LuizBraz13/TCU-Projects/Anexo1_TER/IEL 4 Anexo 1,2 e sede-Instalação elétrica-Iluminação-Térreo-IEL 4.pdf

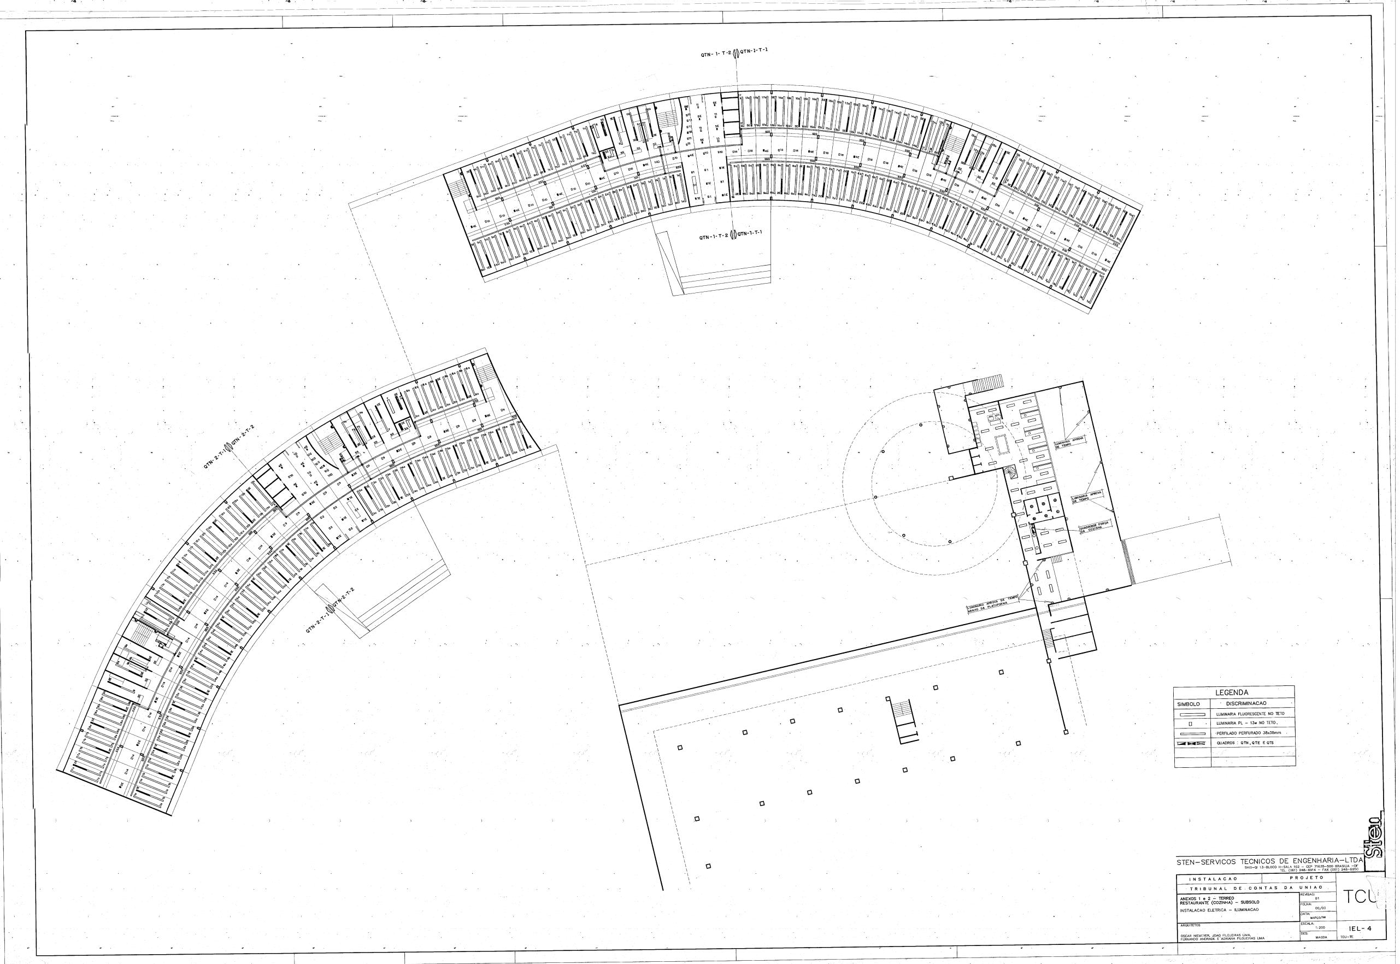
[picture p1: page 1]
