LuizBraz13/TCU-Projects/(list of files, cad)

Other CAD files:
Anexo1_PAV2/AN 1_2 PAVc.dwg
Anexo1_PAV4/AN 1_4 PAV_2017c.dwg
Anexo1_SUB/AN 1_SUBc.dwg
Anexo1_TER/02-01_ANEXO-I_TER_ILUMINAÇÃO_R00.dwg
Anexo_I_II_PERGOLADO.DWG/INTERCONEXÃO DOS MÓDULOS_ANEXO I, II e PERGOLADO.dwg
Check list PE Anexo I,II e Pergolado/2018-06-05 PROJETOS_V02/DWG/ALOCAÇÃO DOS MÓDULOS/ALOCAÇÃO DE MÓDULOS - ANEXO I, II e PERGOLADO.dwg
Check list PE Anexo I,II e Pergolado/2018-06-12 PROJETOS_V01/ALOCAÇÃO DE MÓDULOS/ALOCAÇÃO DE MÓDULOS_ANEXO I, II e PERGOLADO_v10.dwg
Check list PE Anexo I,II e Pergolado/2018-06-12 PROJETOS_V01/INFRAESTRUTURA/INFRAESTRUTURA_TCU_ANEXO I, II e Pergolado_v09.dwg
Check list PE Anexo I,II e Pergolado/2018-06-12 PROJETOS_V01/INTERCONEXÃO DOS MÓDULOS/INTERCONEXÃO DOS MÓDULOS_ANEXO I, II e PERGOLADO.dwg
Check list PE Anexo I,II e Pergolado/2018-06-12 PROJETOS_V01/LEVANTAMENTO NA MANTA - ANEXOS I e II/LEVANTAMENTO DA MANTA - ANEXOS I e II_v02.dwg
Anexo1_PAV2/05-01_ANEXO-I_2PAV_ILUMINAÇÃO_R00.dwg
Anexo1_SUB/01-01_ANEXO-I_SUB_ILUMINAÇÃO_R00c.dwg
Anexo1_TER/01-01_ANEXO-I_TER_ILUMINAÇÃO_R00c.dwg
Anexo_I_II_PERGOLADO.DWG/LEVANTAMENTO DA MANTA - ANEXOS I e II.dwg
Anexo1_TER/AN 1_TER_2018c.dwg
