LuizBraz13/TCU-Projects/Anexo1_SUB/AN 1_SUBc.pdf

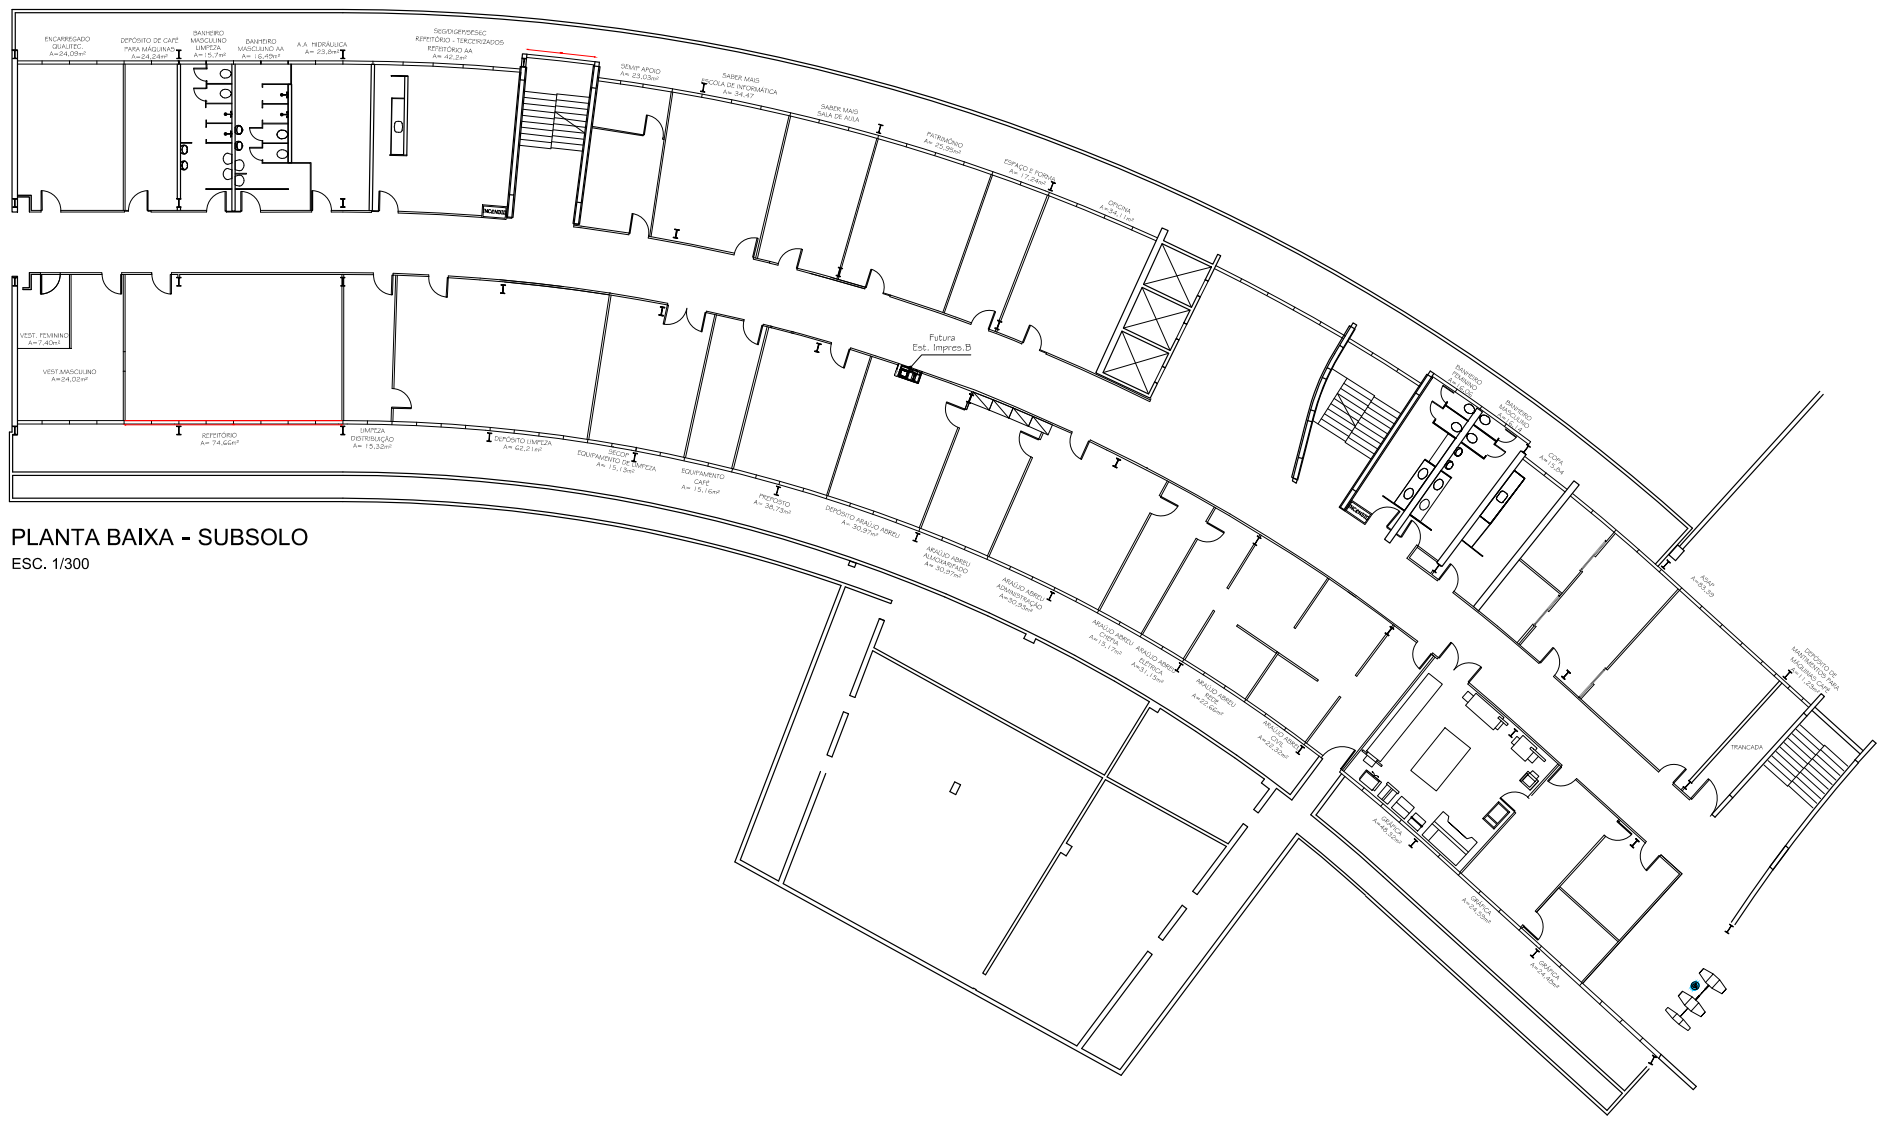
[picture p19: page 1]
