LuizBraz13/TCU-Projects/Anexo1_PAV2/01-01_ANEXO-I_2PAV_ILUMINAÇÃO_R00c.pdf

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

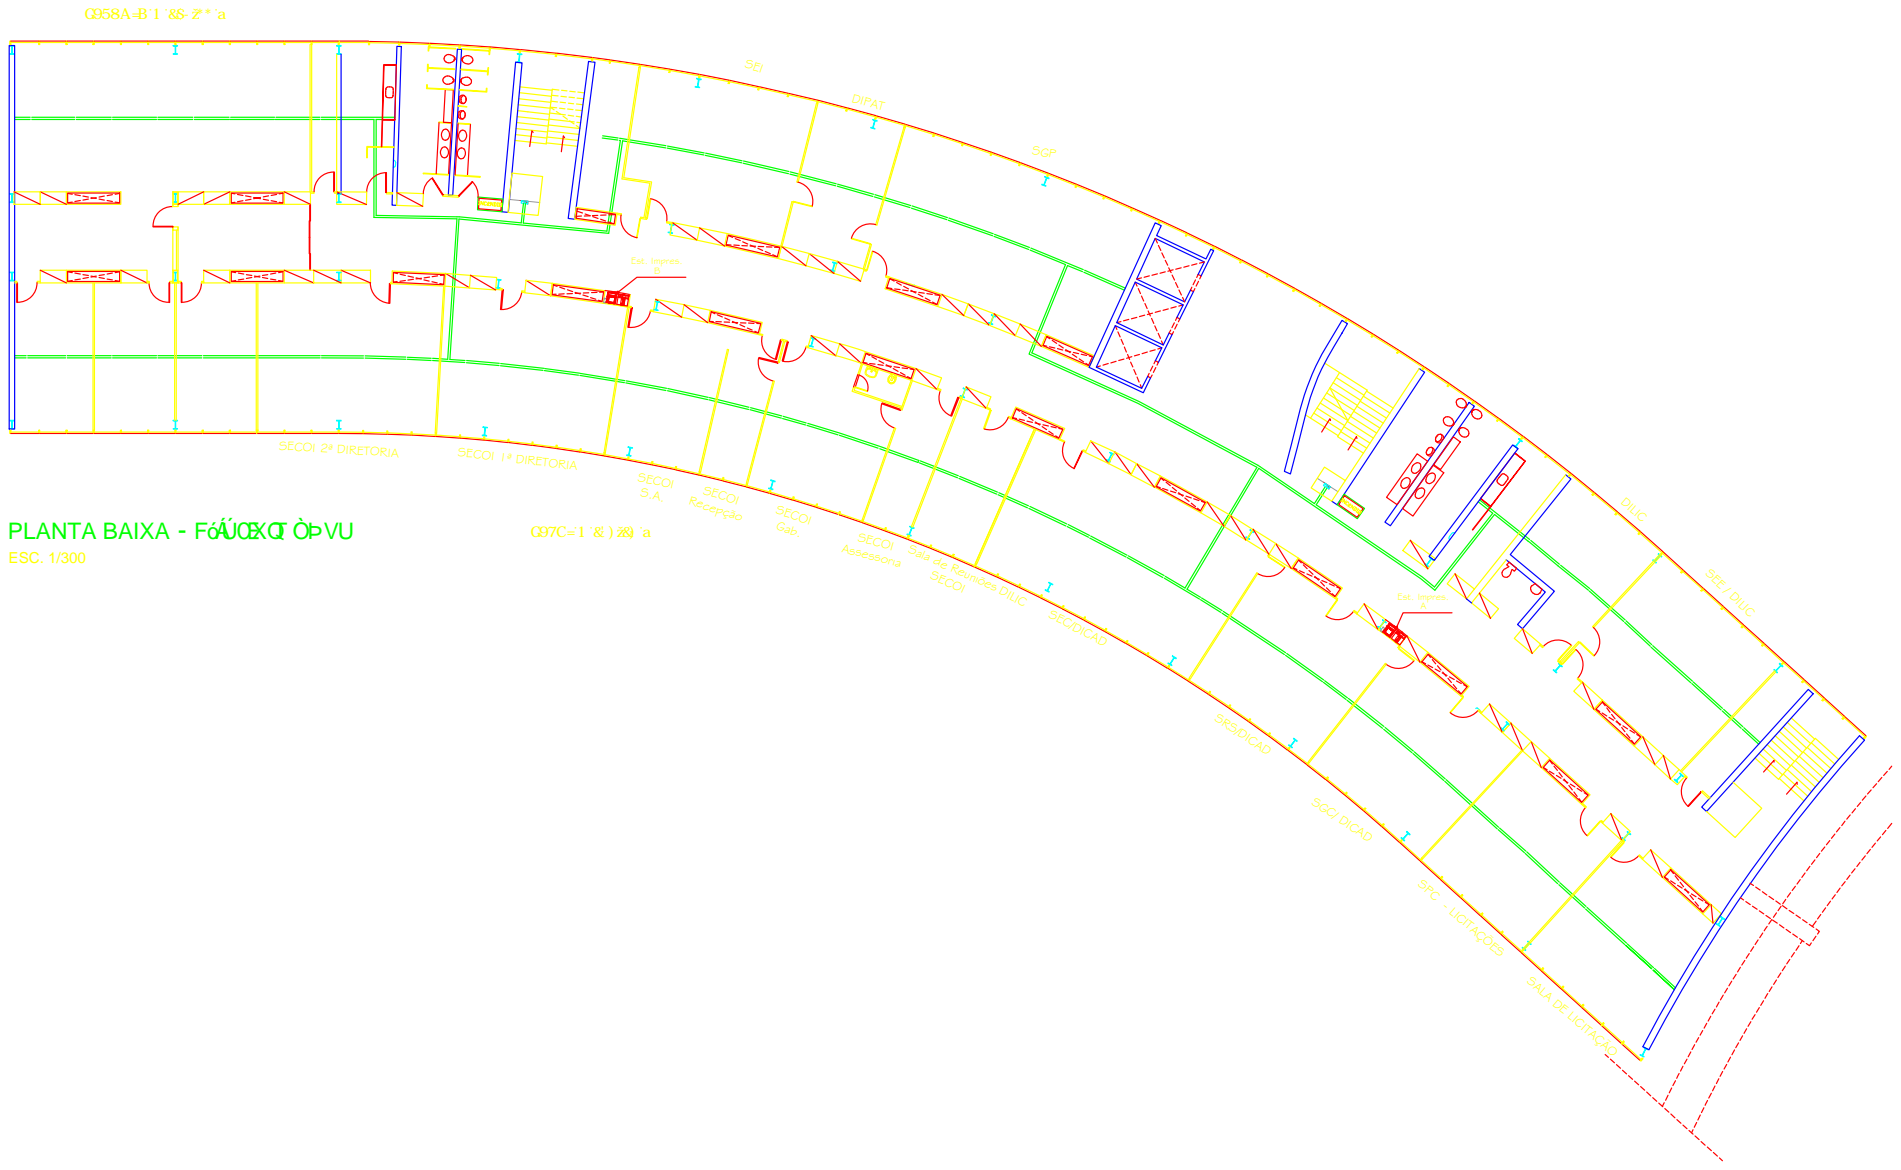
[picture p20: page 1]
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
