LuizBraz13/TCU-Projects/Anexo1_PAV4/01-01_ANEXO-I_4PAV_ILUMINAÇÃO_R00c.pdf

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

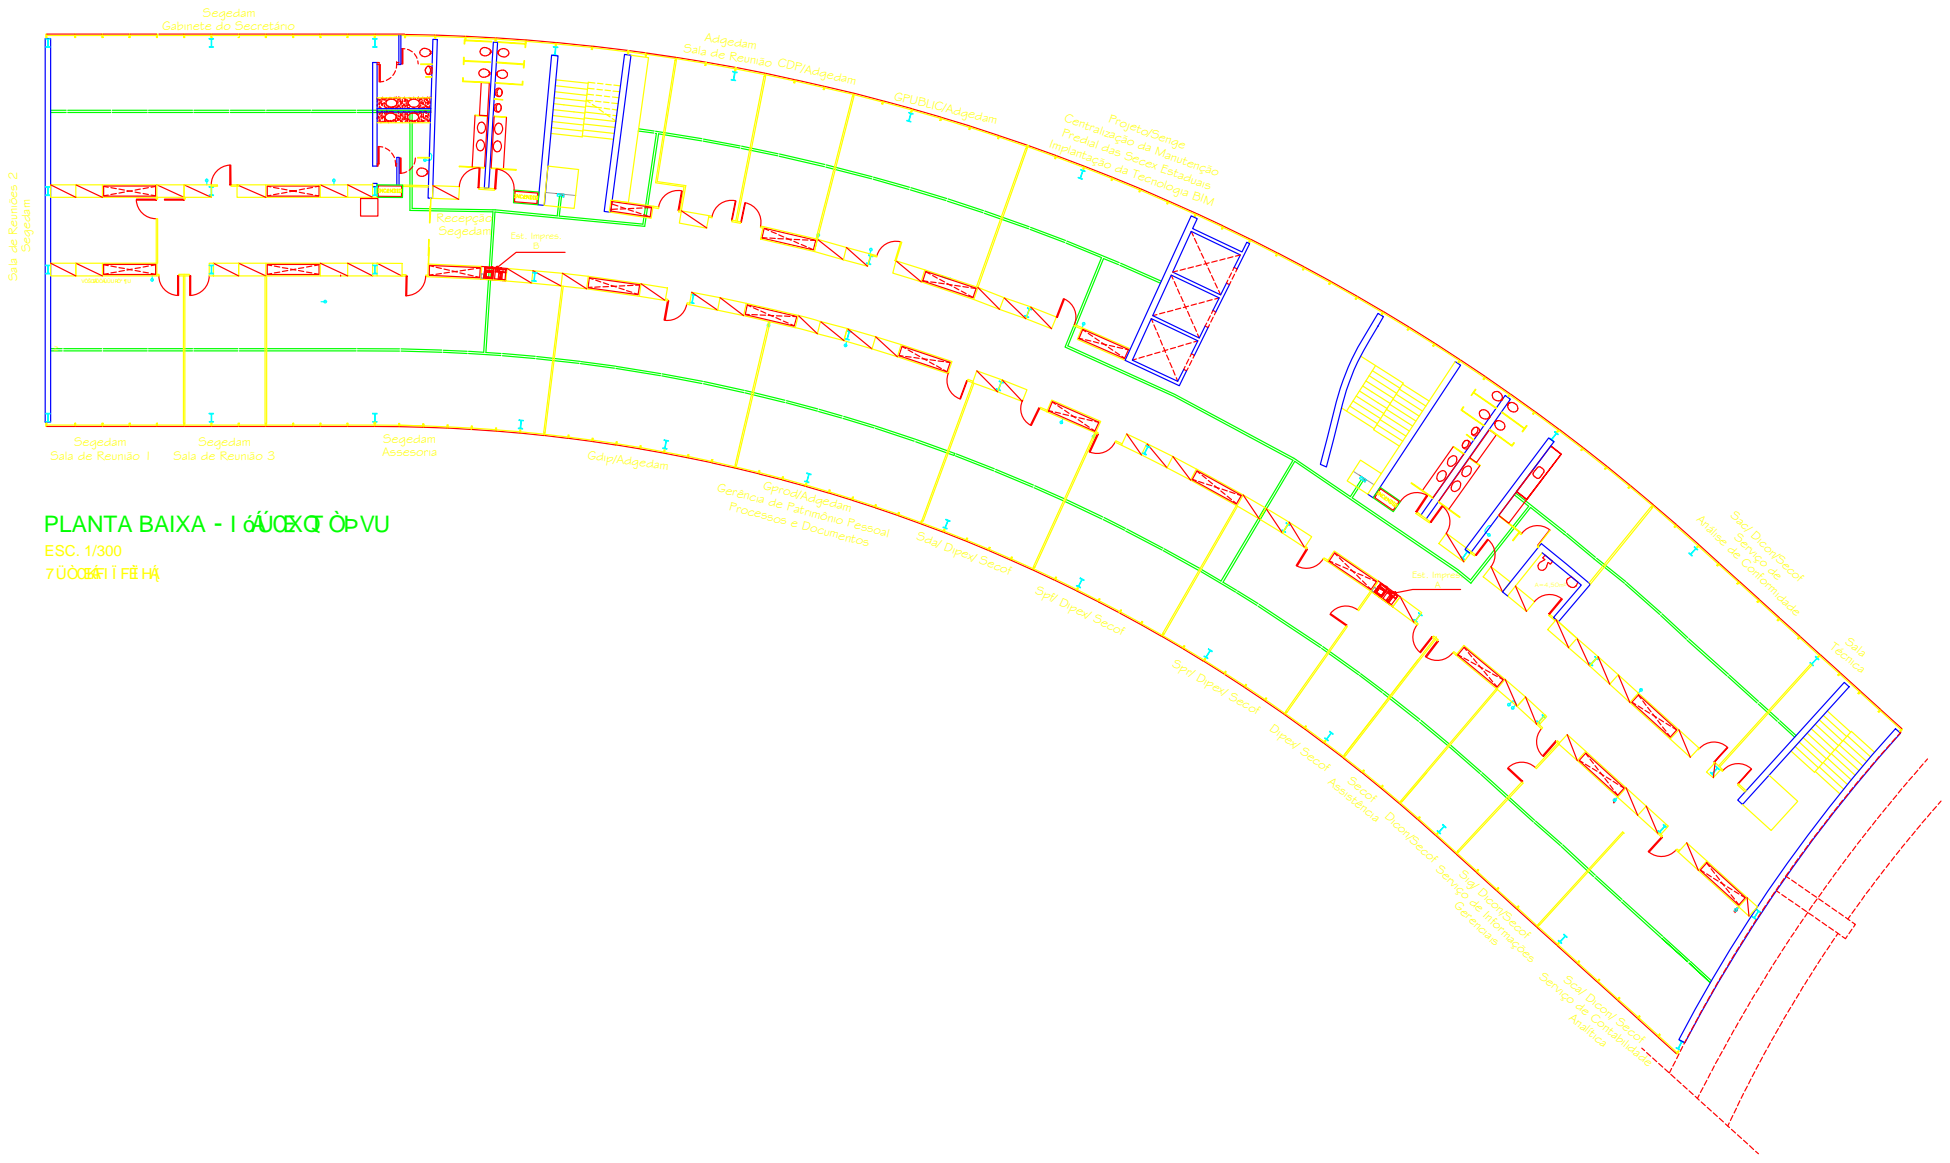
[picture p21: page 1]
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
