LuizBraz13/TCU-Projects/Check list PE Anexo I,II e Pergolado/2018-06-05_Simulação Anexos I II e Pergolado/02-Interconexão/INTERCONEXÃO ANEXO I - 02.pdf

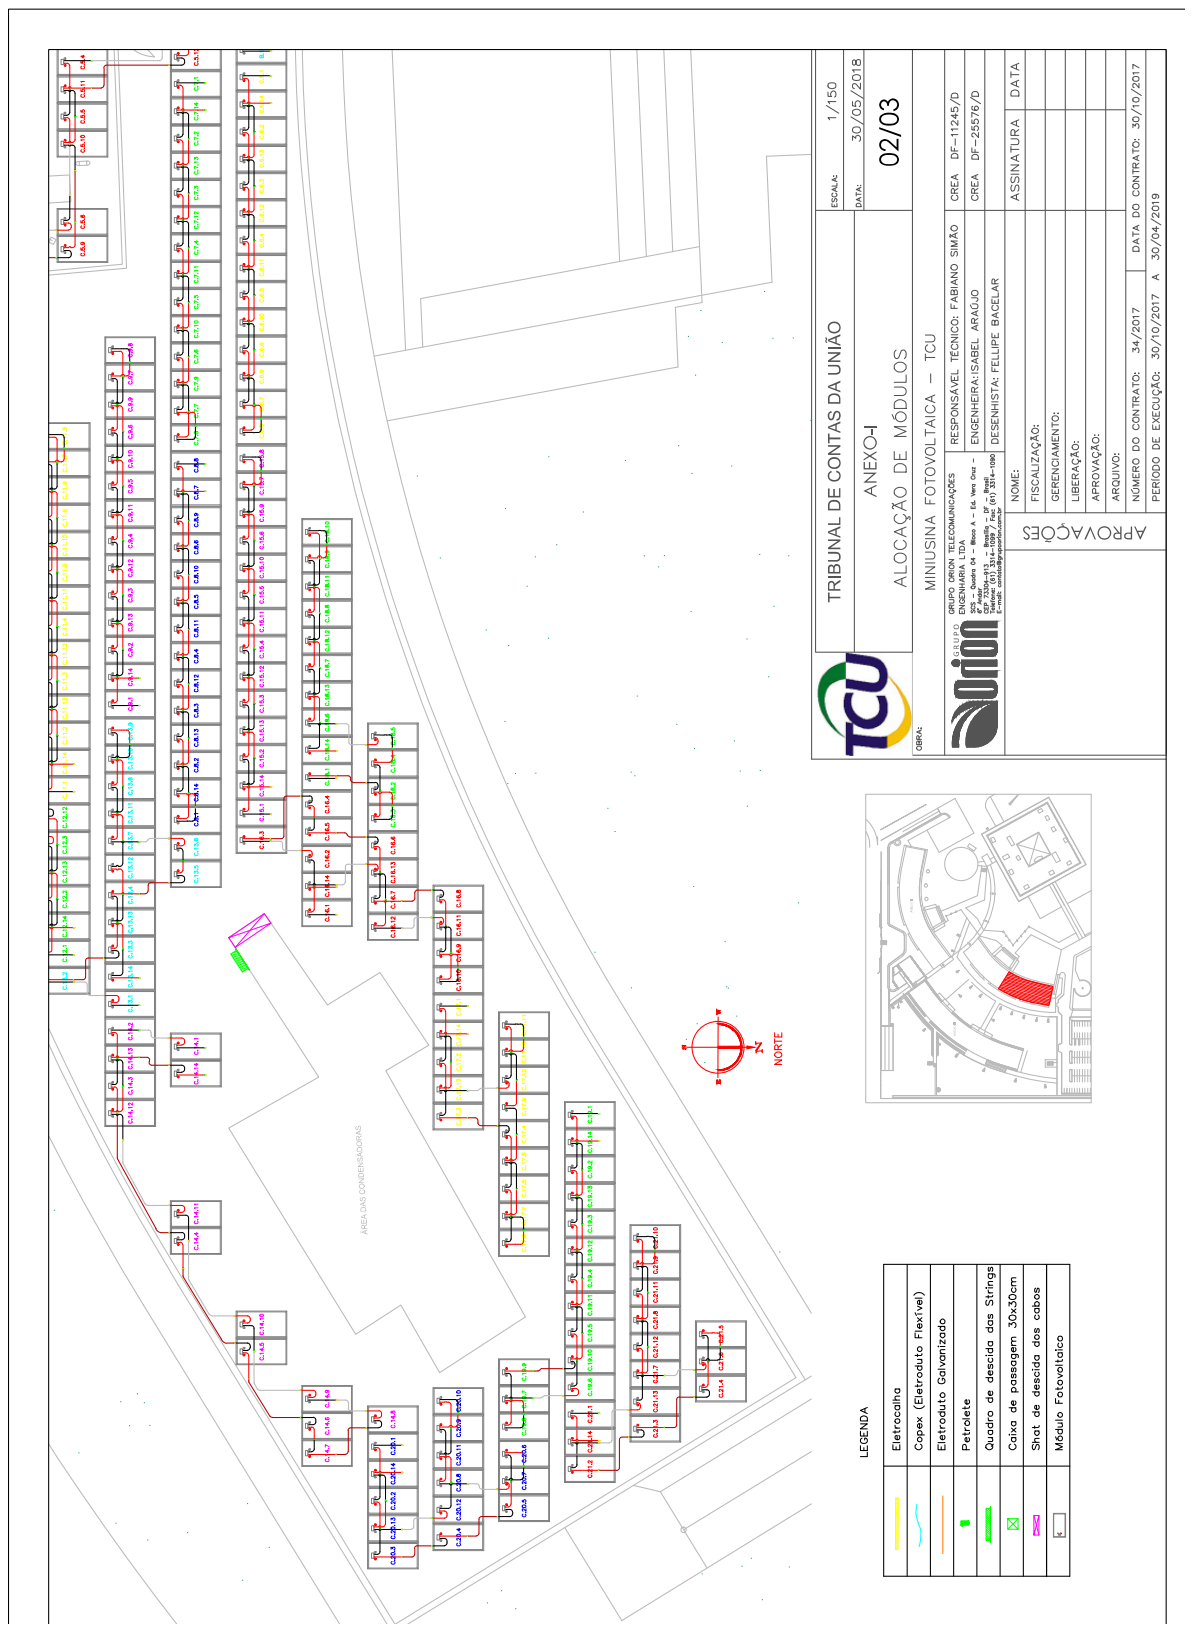
[picture p23: page 1]
