LuizBraz13/TCU-Projects/Check list PE Anexo I,II e Pergolado/2018-06-05_Simulação Anexos I II e Pergolado/02-Interconexão/INTERCONEXÃO ANEXO II - 02.pdf

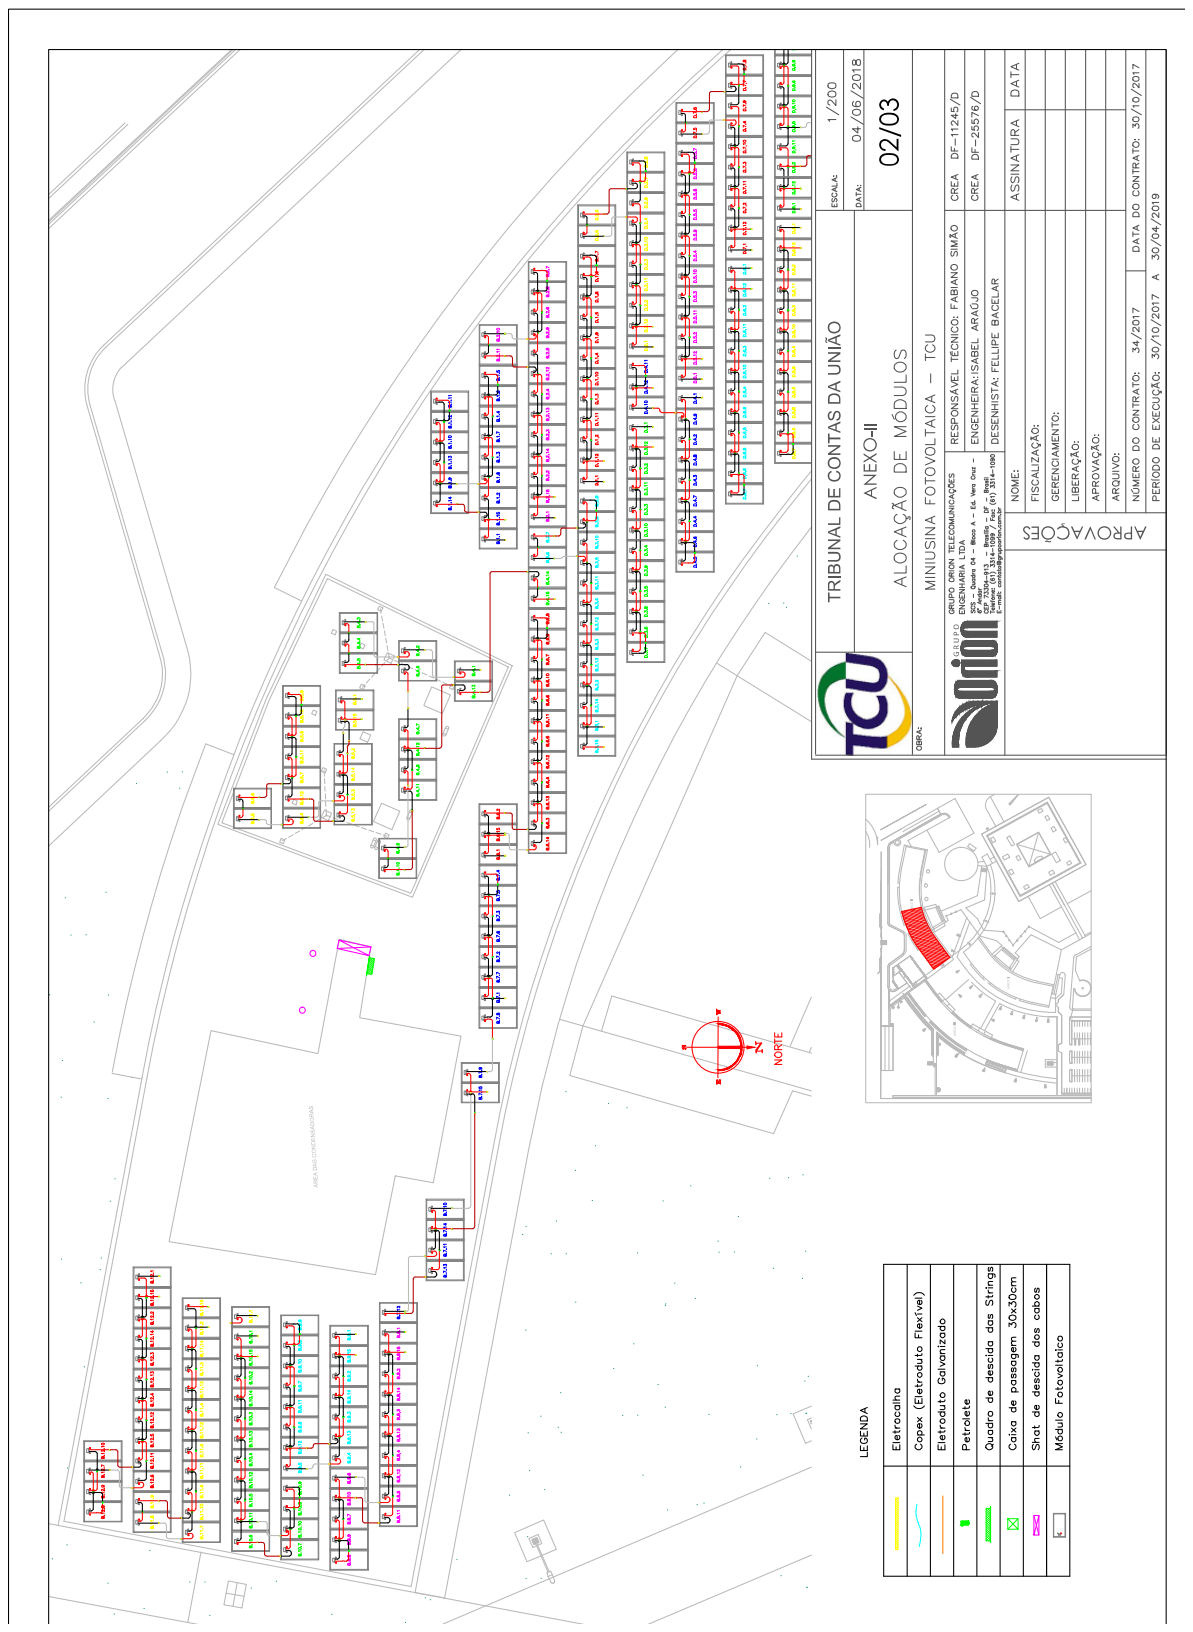
[picture p26: page 1]
