LuizBraz13/TCU-Projects/Check list PE Anexo I,II e Pergolado/2018-06-12 PROJETOS_V01/ALOCAÇÃO DE MÓDULOS/ALOCAÇÃO DE MÓDULOS ANEXO II 03.pdf

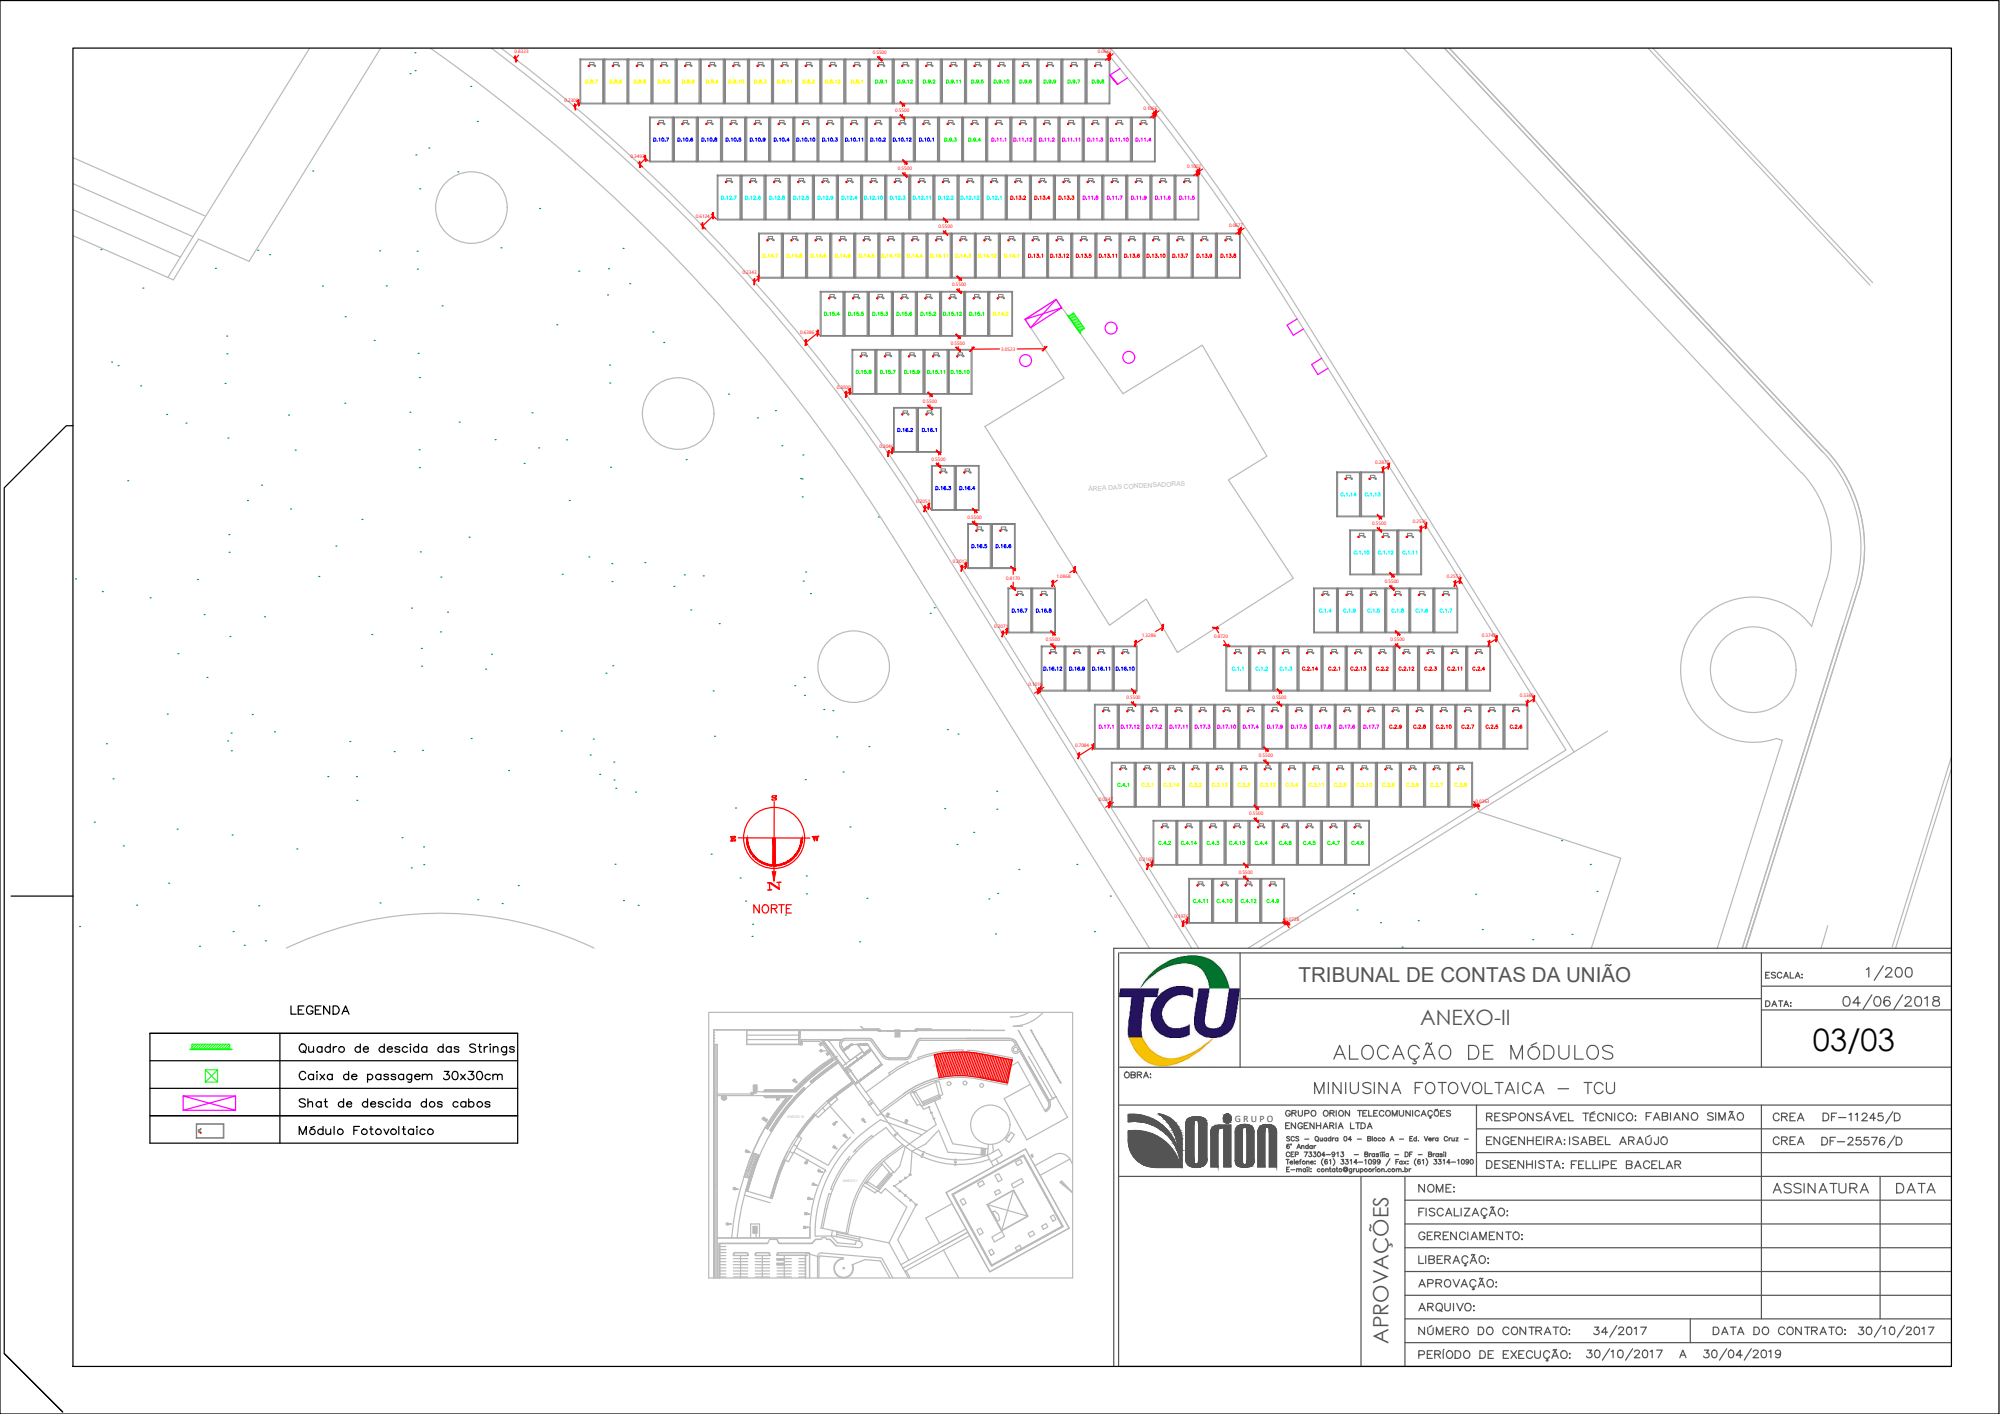
[picture p33: page 1]
ANEXO I; ANEXO II; ANEXO III

ÁREA DAS CONDENSADORAS

TRIBUNAL DE CONTAS DA UNIÃO
