LuizBraz13/TCU-Projects/Check list PE Anexo I,II e Pergolado/2018-06-12 PROJETOS_V01/INFRAESTRUTURA/INFRA ANEXO I 01.pdf

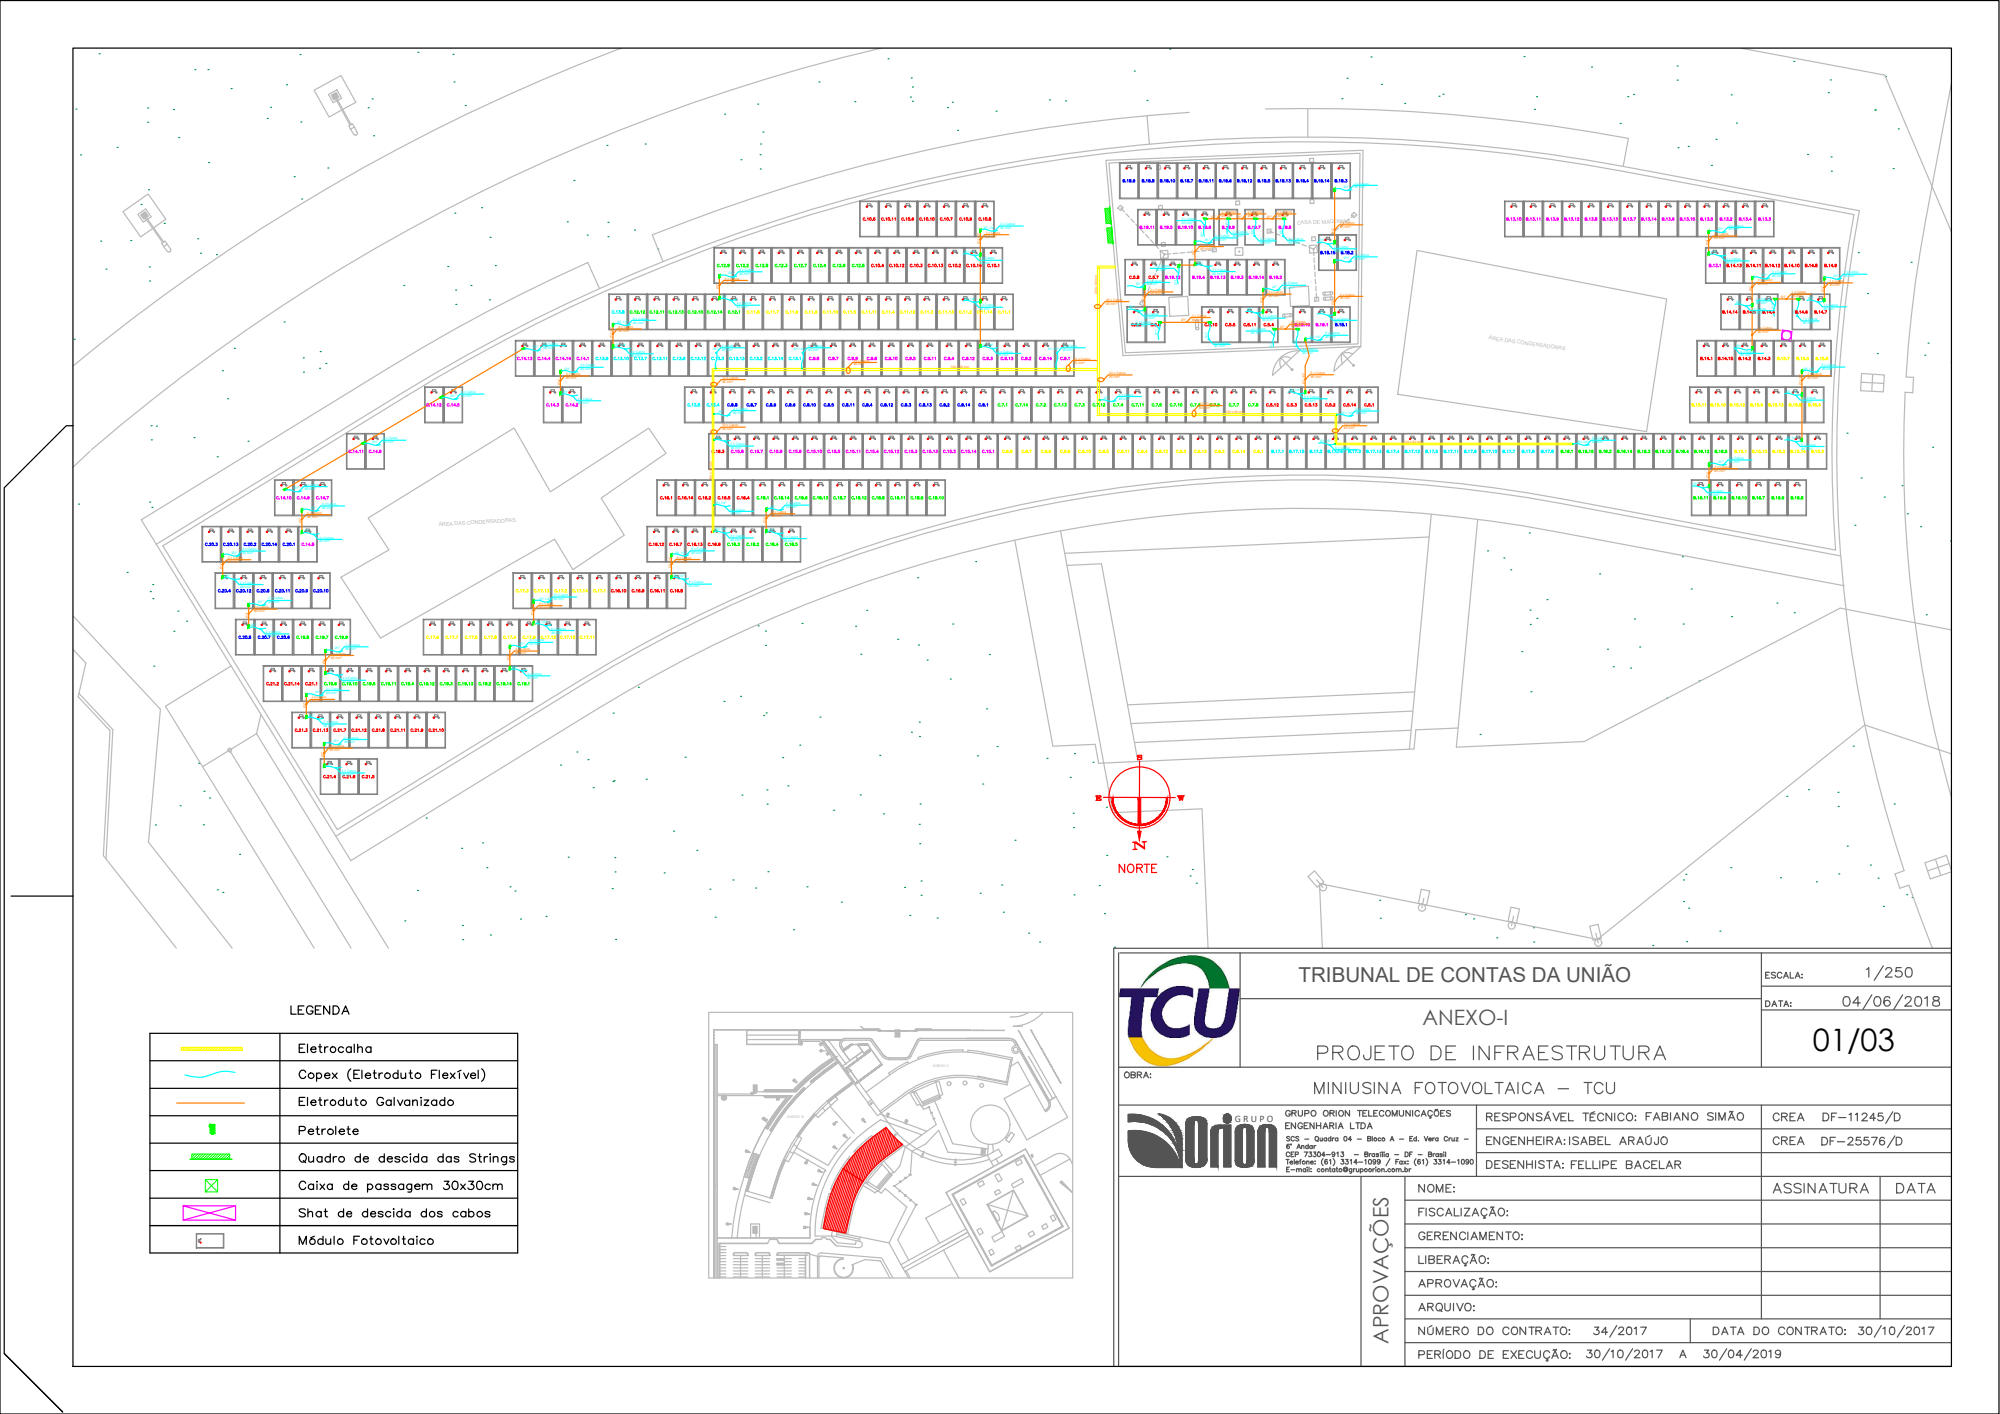
[picture p35: page 1]
2 x Cabos #6 mm² Ø1"; 2 x Cabos #6 mm²; 1 x Cabos #6 mm² Ø1"; 1 x Cabos #6 mm²; 3 x Cabos #6 mm² Ø1"; 3 x Cabos #6 mm²; Ø1"4 x Cabos #6 mm²; 2 x Cabos #6 mm² Ø1.1/4"; 6 x Cabos #6 mm²; 2 x Cabos #6 mm² Ø1" Ø1"; 6 x Cabos #6 mm² Ø1.1/4"; 2 x Cabos Ø1"; #6 mm² Ø1"; 4 x Cabos Ø1"; 4 x Cabos #6 mm²; 4 x Cabos #6 mm² Ø1"; #6 mm² 2 x Cabos Ø1"; 1 x Cabos Ø1"; 8 x Cabos #6 mm² Ø1.1/4"; 8 x Cabos #6 mm²; 10 x Cabos #6 mm²; 12 x Cabos #6 mm² 100 x 50 mm; Ø1.1/4" 8 x Cabos Ø1.1/4"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

CASA DE MÁQUINAS

ÁREA DAS CONDENSADORAS

TRIBUNAL DE CONTAS DA UNIÃO
