LuizBraz13/TCU-Projects/Check list PE Anexo I,II e Pergolado/2018-06-12 PROJETOS_V01/INFRAESTRUTURA/INFRA ANEXO I 02.pdf

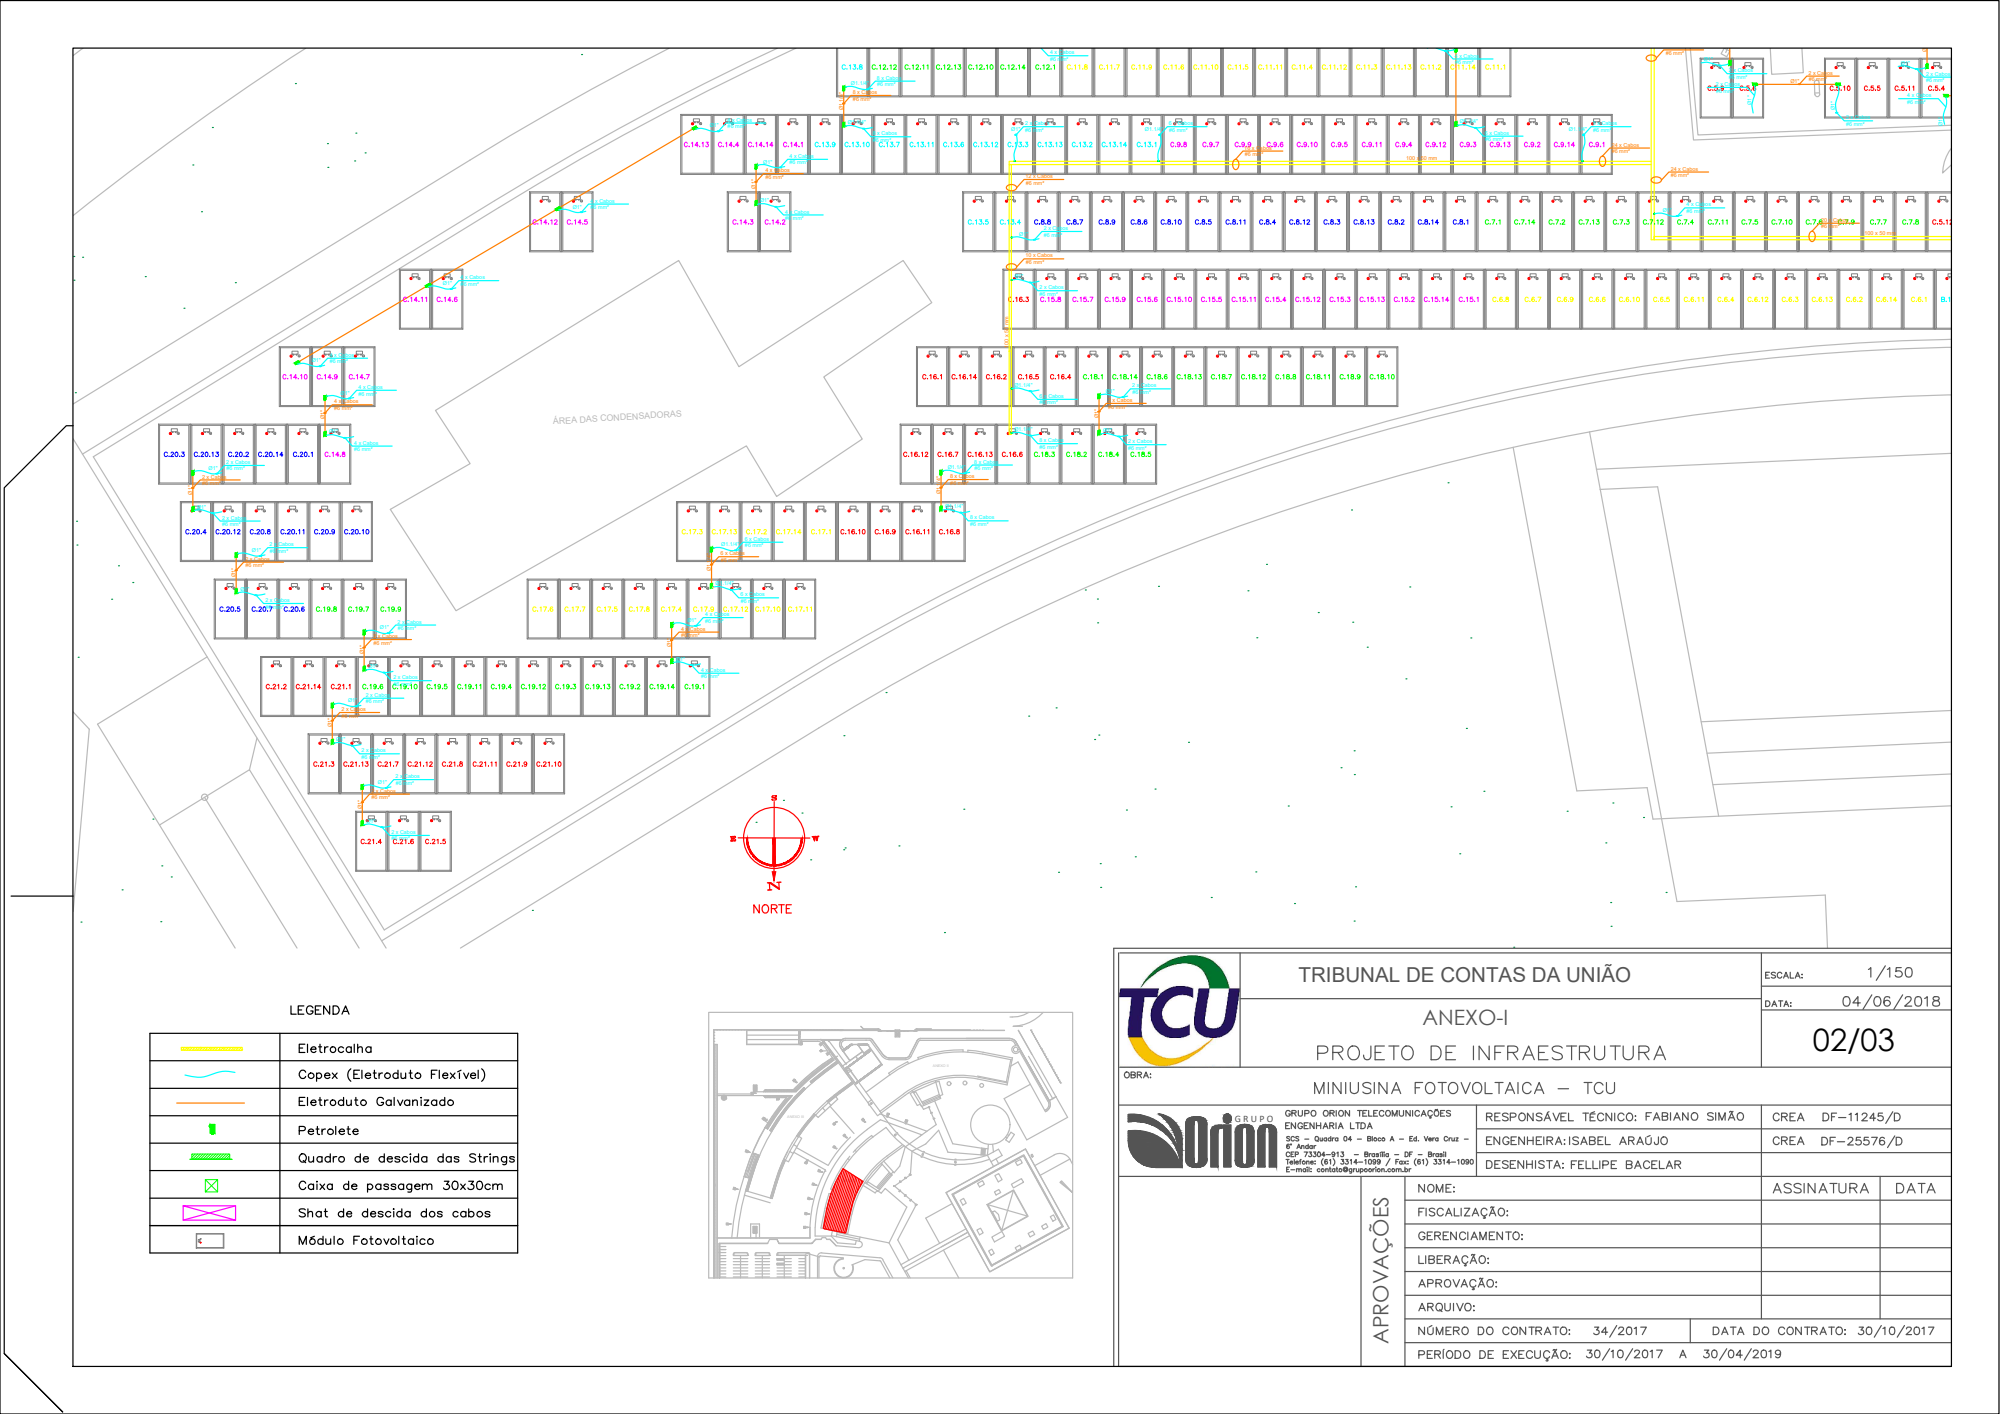
[picture p36: page 1]
2 x Cabos #6 mm²; 2 x Cabos #6 mm² 2 x Cabos Ø1"; #6 mm² Ø1"; 4 x Cabos #6 mm²; 2 x Cabos #6 mm² Ø1"; 4 x Cabos #6 mm² Ø1"; 6 x Cabos #6 mm² Ø1.1/4"; 6 x Cabos #6 mm²; 8 x Cabos #6 mm² Ø1.1/4"; 8 x Cabos #6 mm²; 10 x Cabos #6 mm²; Ø1.1/4" 8 x Cabos Ø1.1/4"; #6 mm² 6 x Cabos Ø1"; #6 mm² 2 x Cabos #6 mm²; 48 x Cabos #6 mm²; 24 x Cabos #6 mm²; 16 x Cabos #6 mm²; 20 x Cabos #6 mm²; ANEXO I; ANEXO II; ANEXO III

ÁREA DAS CONDENSADORAS Ø1"

12 x Cabos #6 mm² 100 x 50 mm

TRIBUNAL DE CONTAS DA UNIÃO
