LuizBraz13/TCU-Projects/Check list PE Anexo I,II e Pergolado/2018-06-12 PROJETOS_V01/INFRAESTRUTURA/INFRA ANEXO II 02.pdf

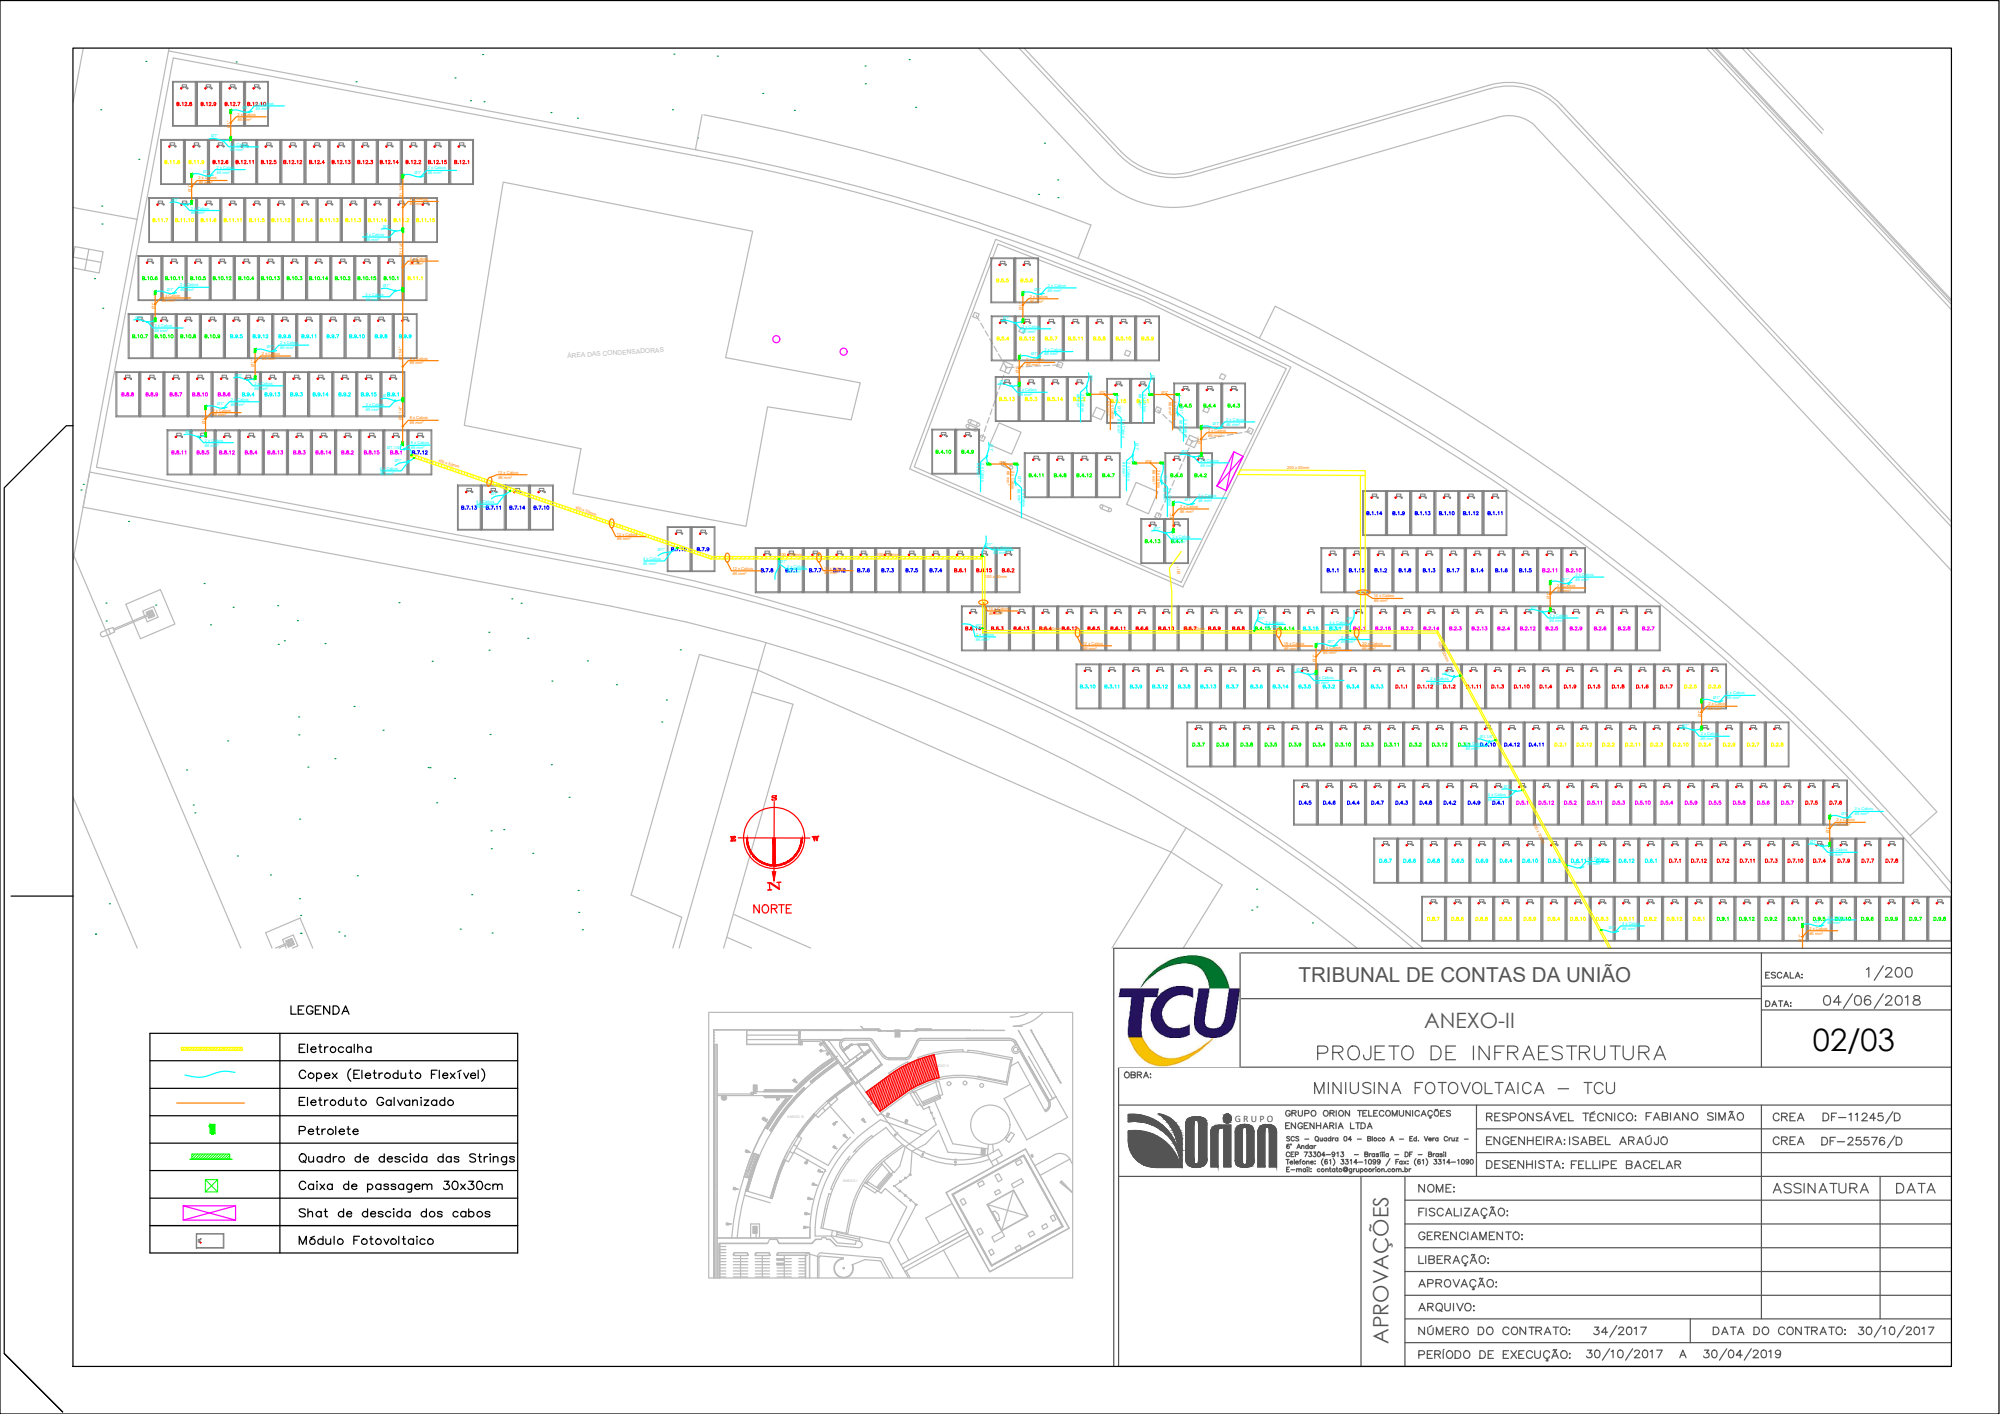
[picture p38: page 1]
2 x Cabos #6 mm² Ø1"; 2 x Cabos #6 mm²; 4 x Cabos #6 mm²; Ø1" 4 x Cabos #6 mm²; 8 x Cabos #6 mm²; 2 x Cabos #6 mm² Ø1.1/4"; Ø1" 2 x Cabos #6 mm²; Ø1" 3 x Cabos #6 mm²; 8 x Cabos #6 mm² Ø1.1/4" Ø1.1/4"; 6 x Cabos #6 mm² Ø1.1/4"; 12 x Cabos #6 mm²; 14 x Cabos #6 mm²; Ø1.1/4" 6 x Cabos #6 mm²; 16 x Cabos #6 mm²; 2 x Cabos #6 mm² #6 mm²; 2 x Cabos Ø1"; Ø1" #6 mm² 2 x Cabos Ø1" #6 mm² 2 x Cabos; #6 mm²; 2 x Cabos #6 mm² #6 mm² 2 x Cabos Ø1"; Ø1" #6 mm² 2 x Cabos Ø1" #6 mm²; 2 x Cabos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

ÁREA DAS CONDENSADORAS

2 x Cabos #6 mm² Ø1" Ø1" 2 x Cabos #6 mm² | Ø1" 2 x Cabos #6 mm² | Ø1" 2 x Cabos #6 mm²

Ø1" | 2 x Cabos #6 mm²

Ø1" 4 x Cabos #6 mm² Ø1"2 x Cabos #6 mm²

Ø1" 2 x Cabos #6 mm²

TRIBUNAL DE CONTAS DA UNIÃO
