LuizBraz13/TCU-Projects/Check list PE Anexo I,II e Pergolado/2018-06-12 PROJETOS_V01/INFRAESTRUTURA/INFRA ANEXO II 03.pdf

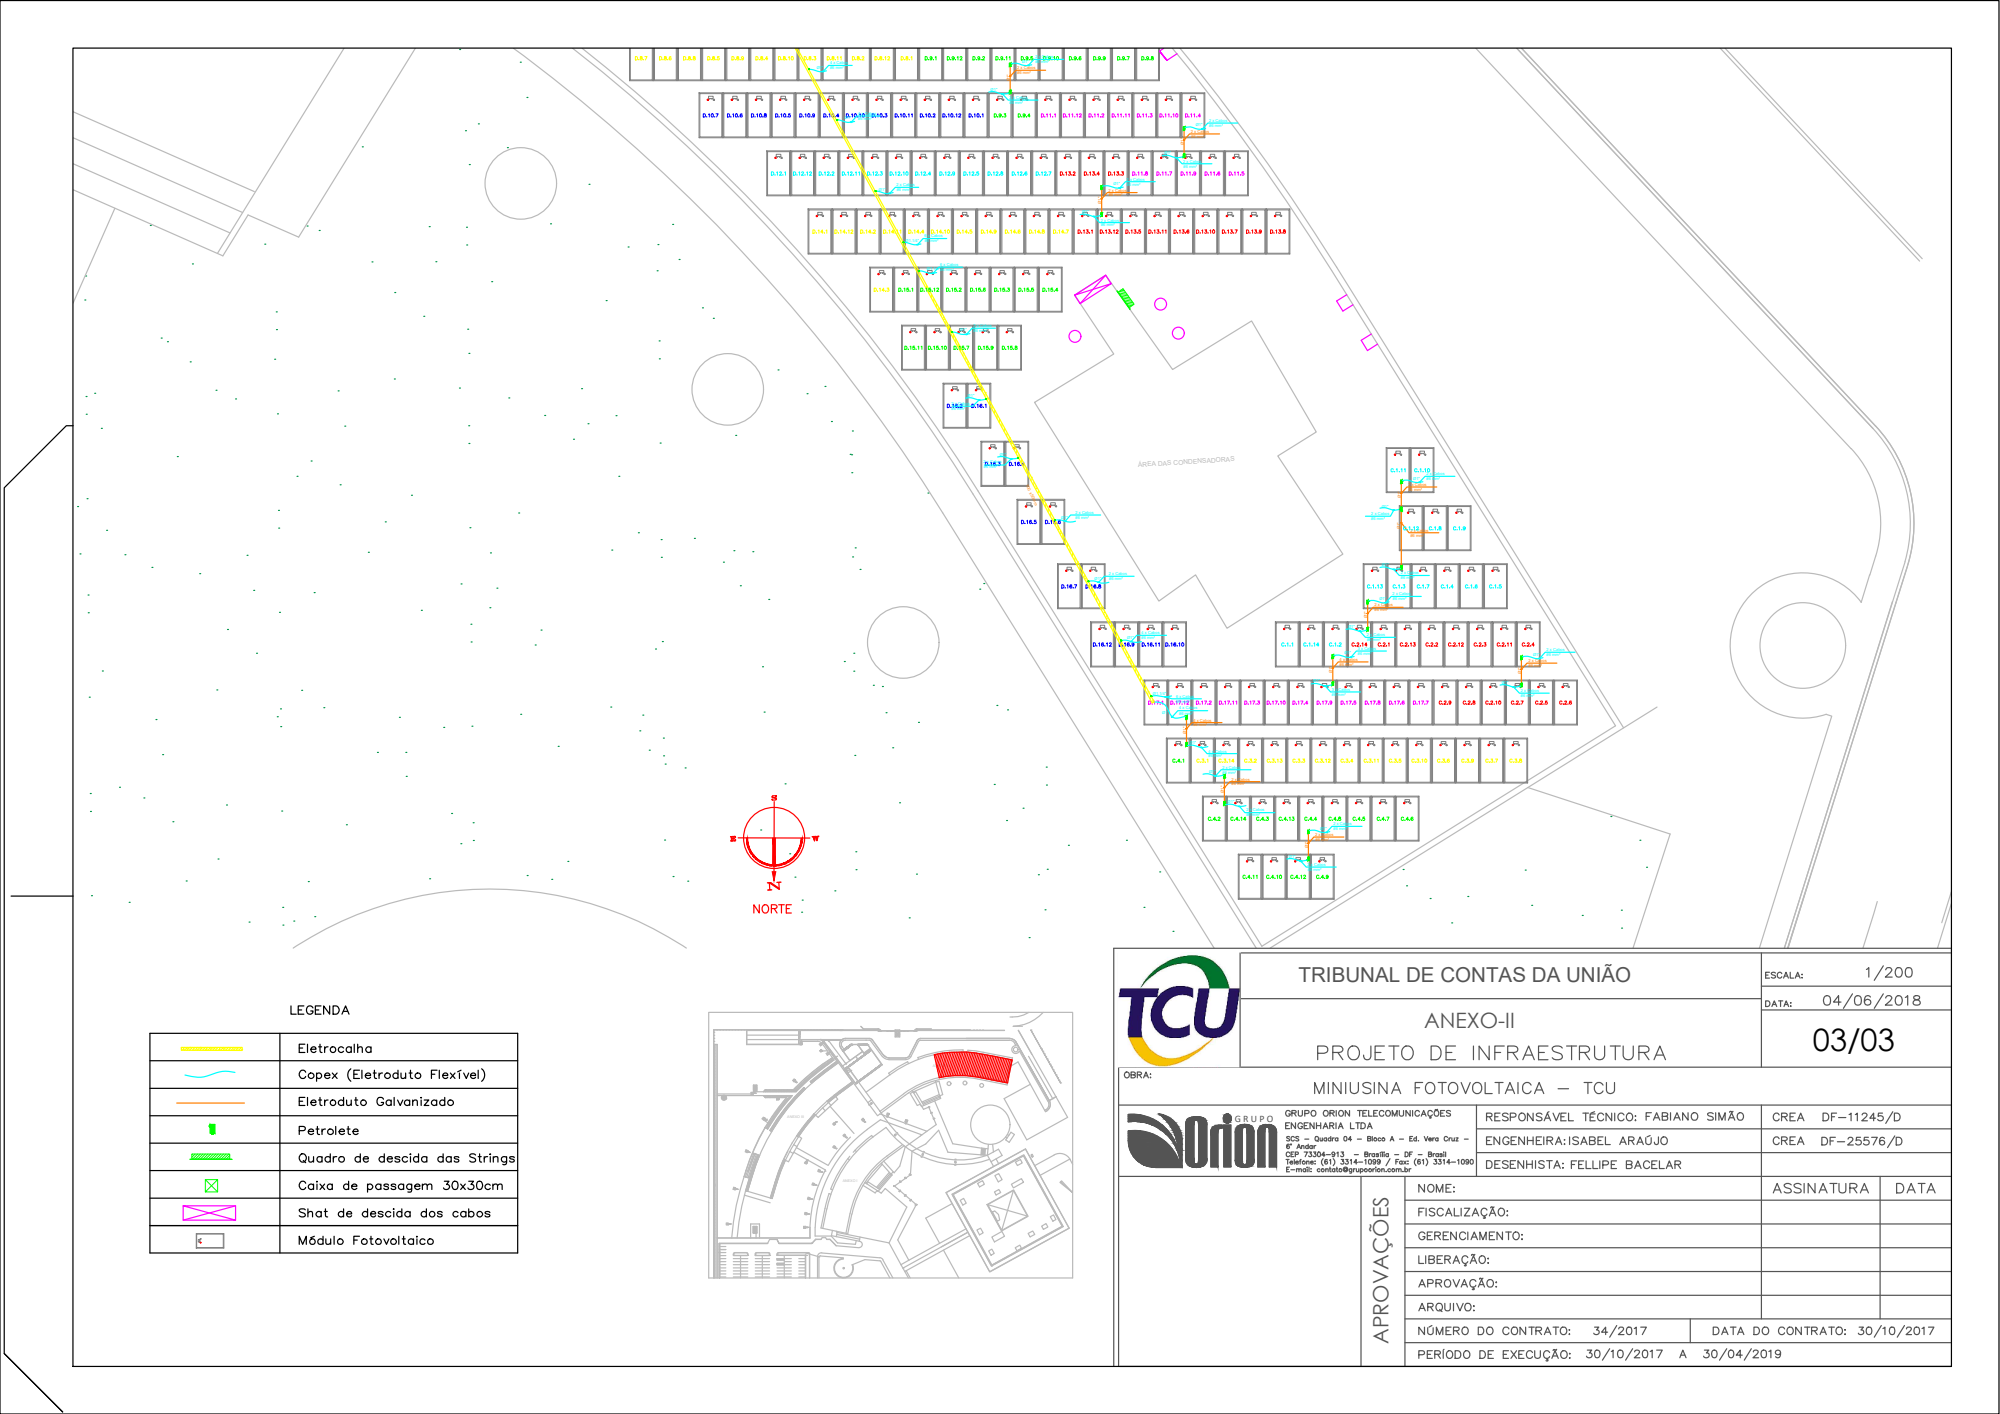
[picture p39: page 1]
2 x Cabos #6 mm² Ø1"; 2 x Cabos #6 mm²; Ø1" 2 x Cabos #6 mm²; 4 x Cabos #6 mm² Ø1"; 3 x Cabos #6 mm²; 4 x Cabos #6 mm²; 6 x Cabos #6 mm²; Ø1.1/4"6 x Cabos #6 mm²; ANEXO I; ANEXO II; ANEXO III; 03/03 ANEXO-II

ÁREA DAS CONDENSADORAS

TRIBUNAL DE CONTAS DA UNIÃO
