LuizBraz13/TCU-Projects/Check list PE Anexo I,II e Pergolado/2018-06-12 PROJETOS_V01/INFRAESTRUTURA/INFRA PERGOLADO.pdf

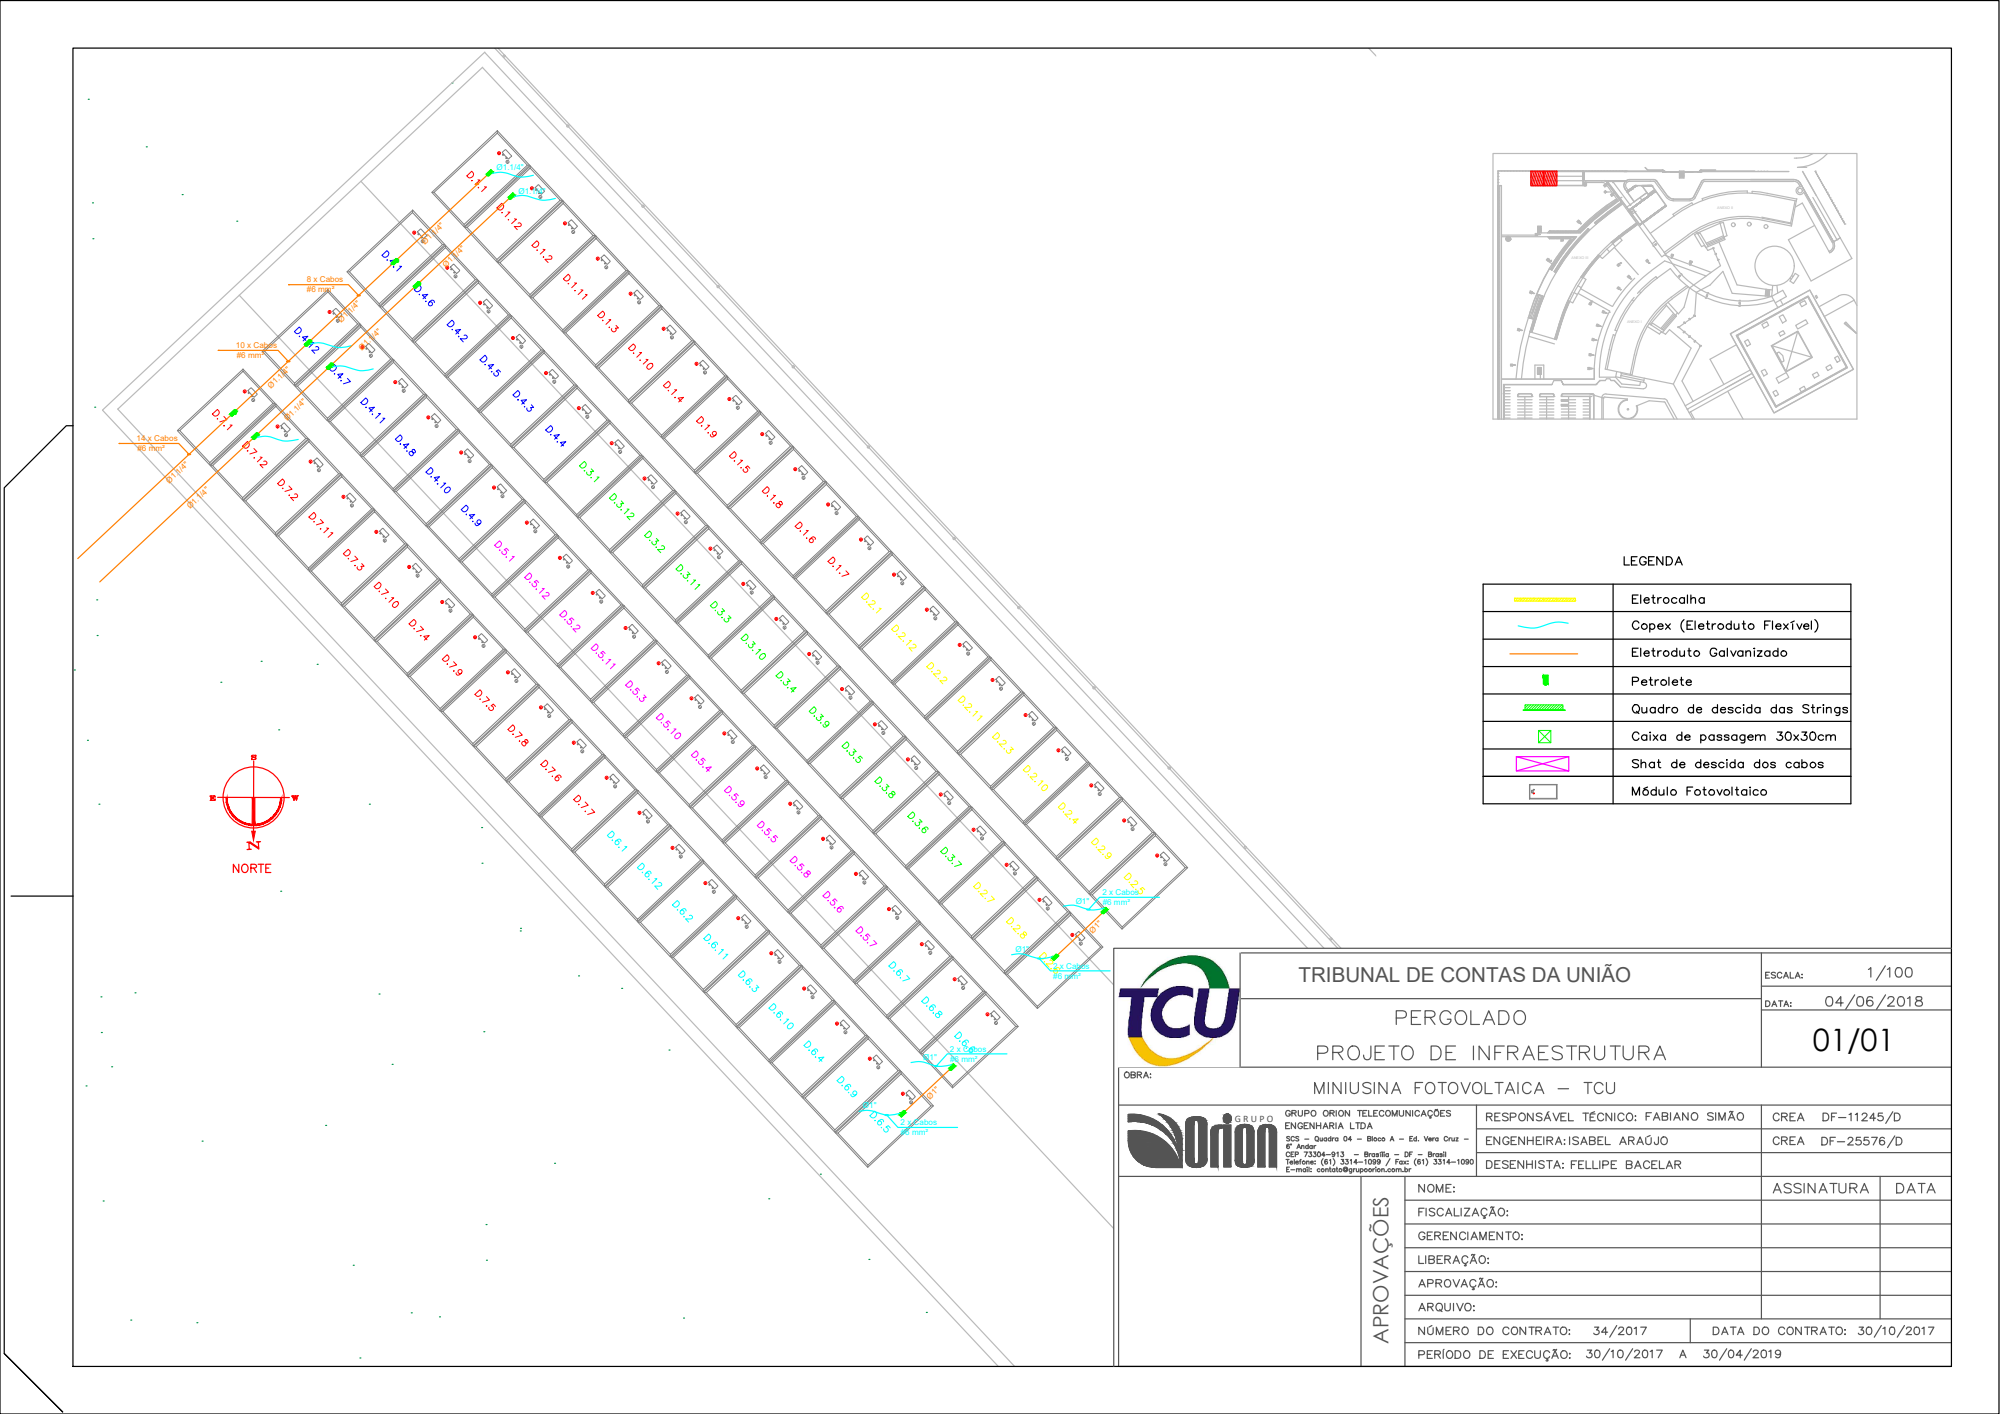
[picture p40: page 1]
ANEXO I; ANEXO II; ANEXO III; 8 x Cabos #6 mm²; 10 x Cabos #6 mm²; 14 x Cabos #6 mm²; 2 x Cabos #6 mm²

TRIBUNAL DE CONTAS DA UNIÃO
