LuizBraz13/TCU-Projects/Check list PE Anexo I,II e Pergolado/2018-06-12 PROJETOS_V01/INTERCONEXÃO DOS MÓDULOS/INTERCONEXÃO PERGOLADO.pdf

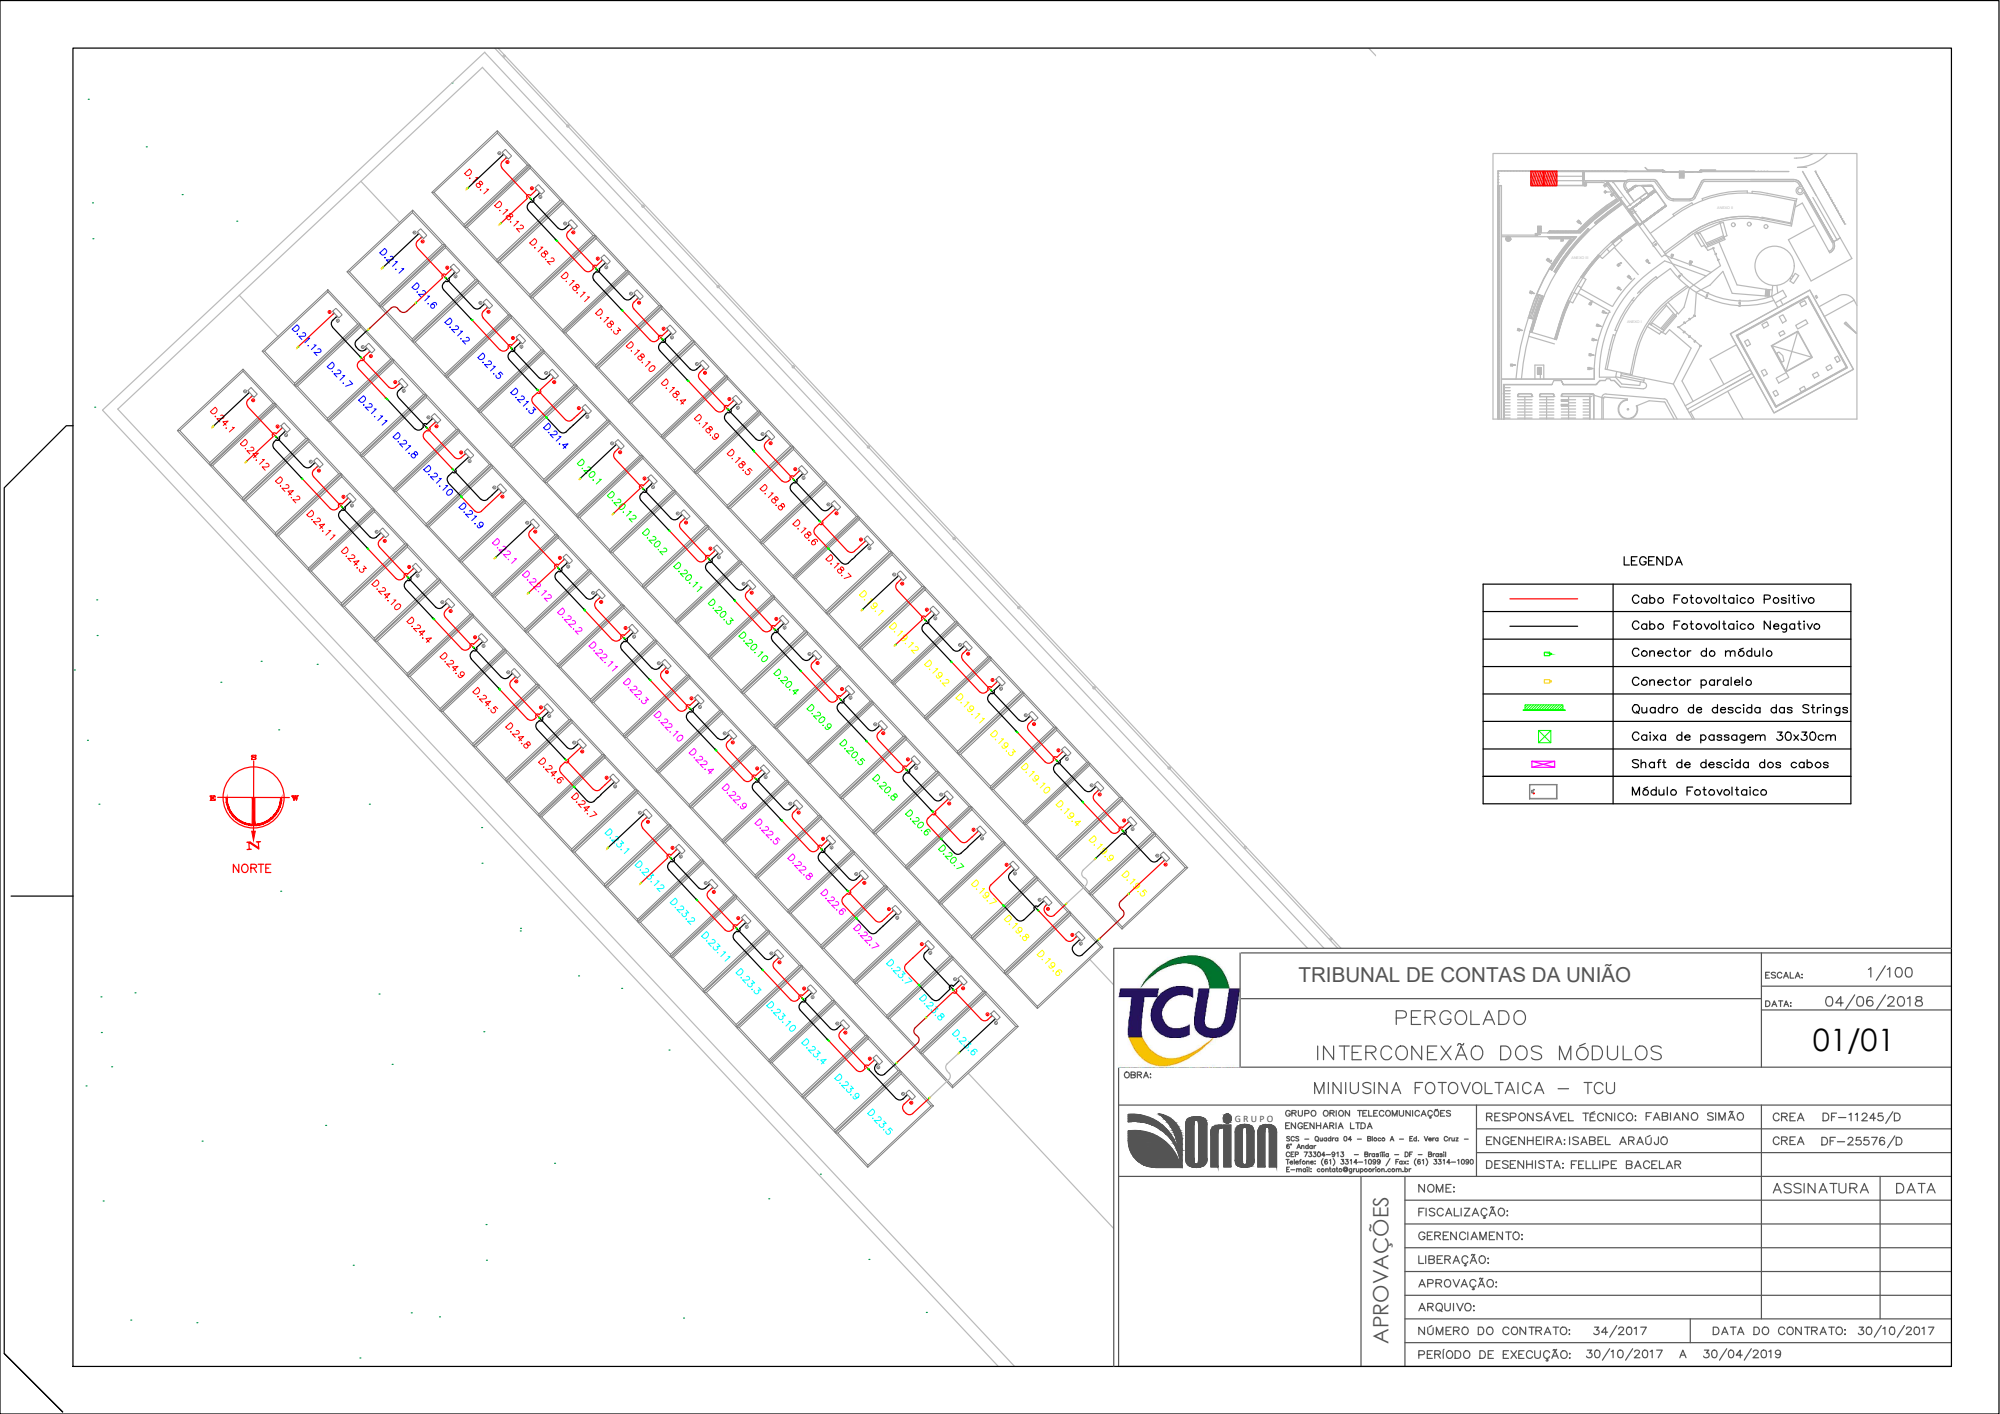
[picture p44: page 1]
ANEXO I; ANEXO II; ANEXO III

TRIBUNAL DE CONTAS DA UNIÃO
