LuizBraz13/TCU-Projects/Check list PE Anexo I,II e Pergolado/2018-06-12 PROJETOS_V01/UNIFILAR/UNIFILAR ANEXO I, II e PERGOLADO.pdf

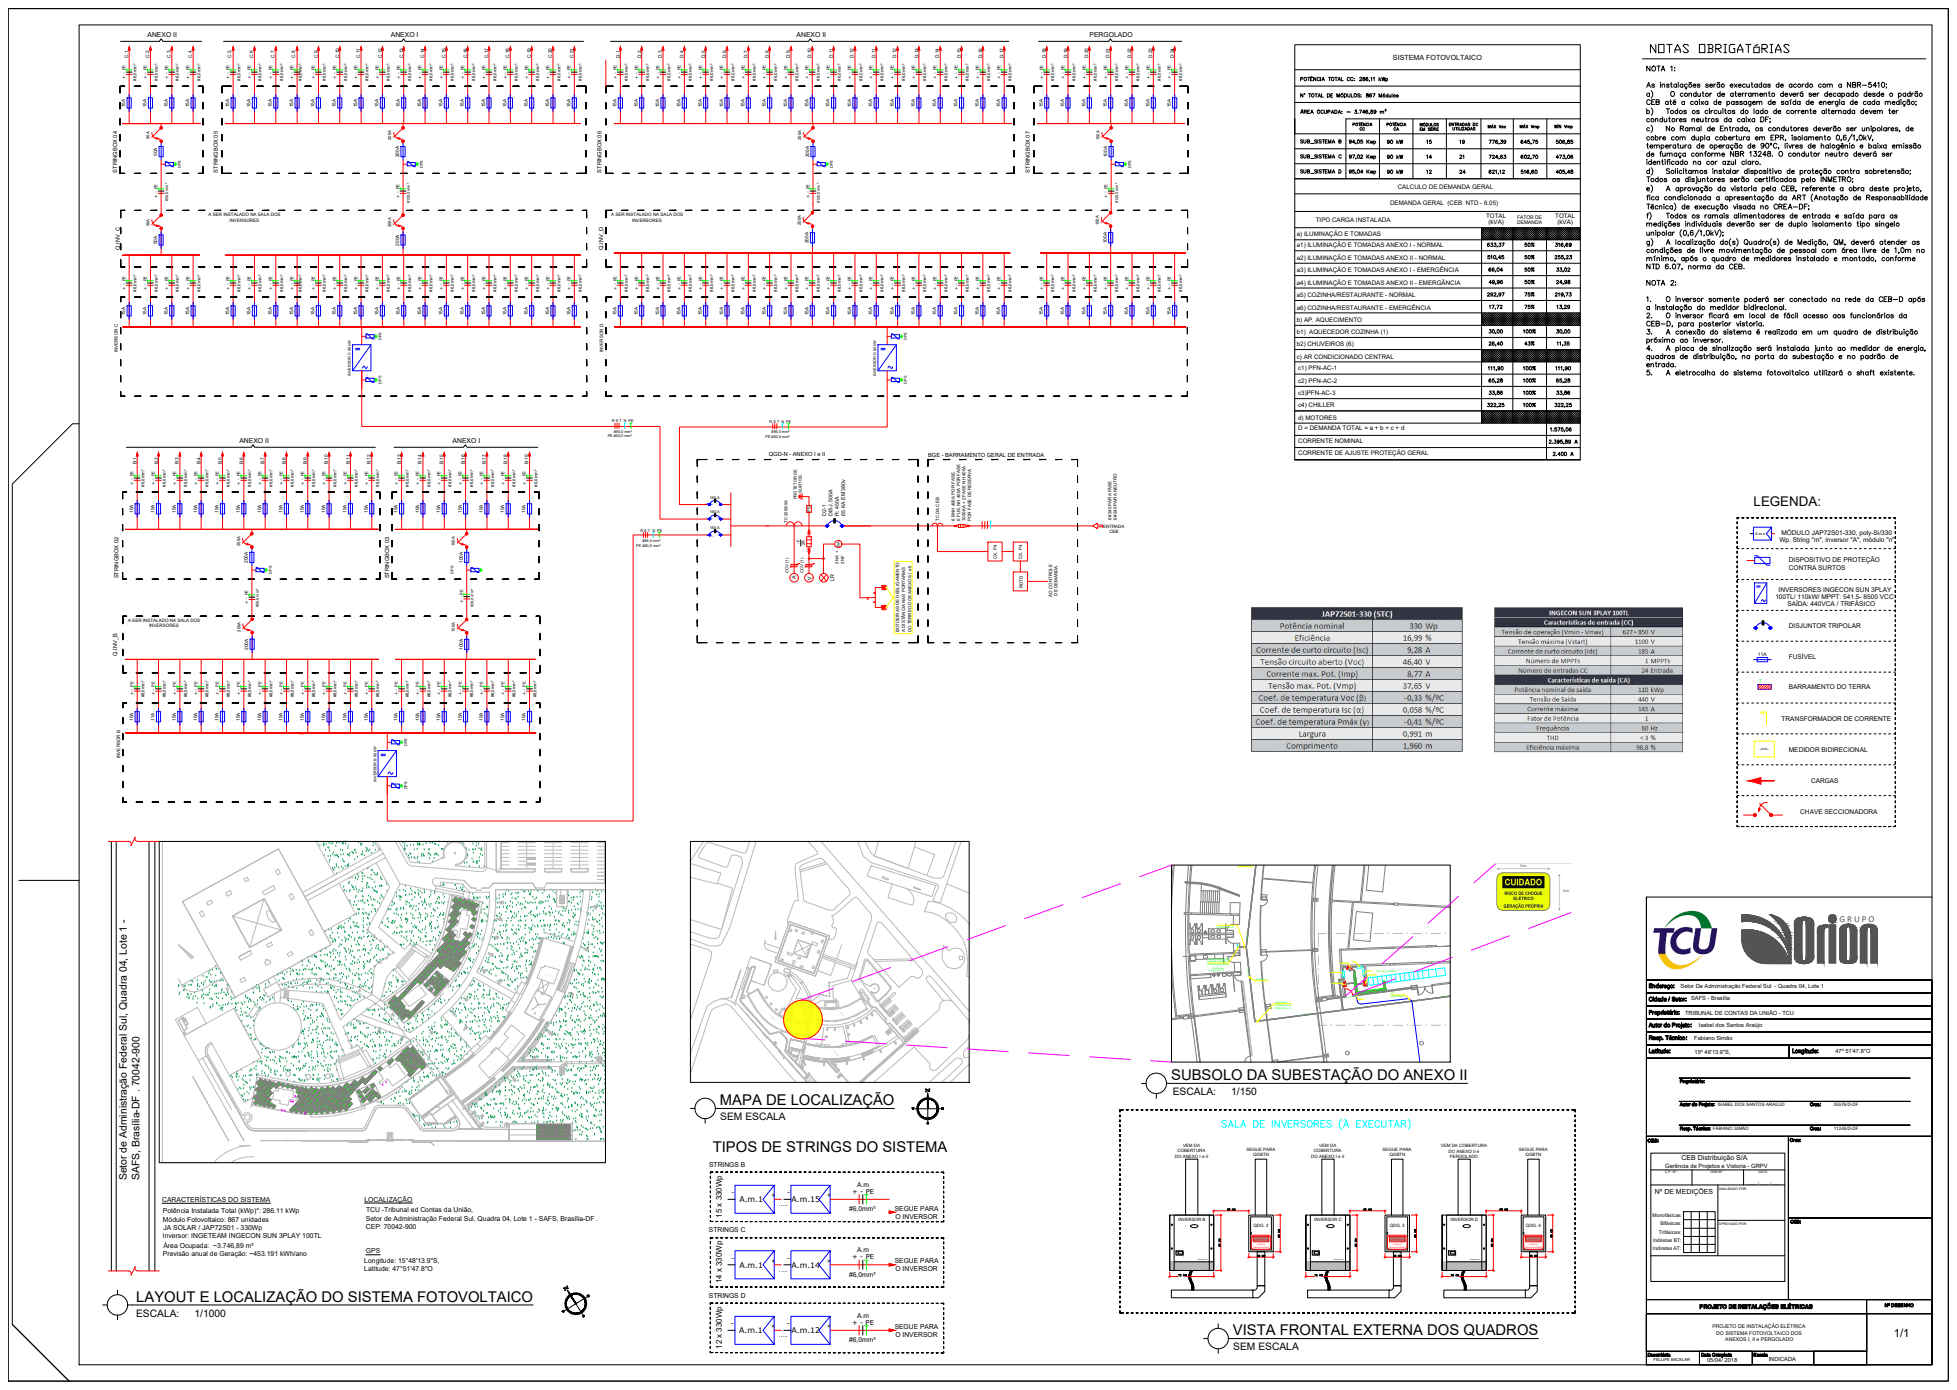
[picture p45: page 1]
STRINGBOX 02; STRINGBOX 03; STRINGBOX 04; STRINGBOX 05; STRINGBOX 07; INVERSOR B 90 kW; DPS DPS; INVERSOR C 90 kW; INVERSOR D 90 kW; INVERSOR B; INVERSOR C; PE #50,0 mm²; STRINGBOX 06; #50,0 mm²; #35,0 mm²; #120,0 mm²; CCV (1); PROTETOR DE; DISJ. 500A; AO CONTROLE; DE DEMANDA; 1000KA + 2 FASE NH 400A; 6 #240 PARA FASE; 6 #240 PARA NEUTRO; #95,0 mm² PE #50,0 mm²; #95,0 mm²; PE #50,0 mm² QGD-N - ANEXO I e II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

#120,0 mm² ANEXO II ANEXO I ANEXO II ANEXO I ANEXO II PERGOLADO

Q.INV_C A SER INSTALADO NA SALA DOS INVERSORES

INVERSOR D R S T N PE #95,0 mm²

6 FUS. NH 400A POR FASE

POR FASE DE RESERVA

6 BNH 400A POR FASE

TC DA CEB

DO TÉRREO DOS ANEXOS I e II ENTRADA CEB

RDTD CX. P4 AV

BOTOEIRAS DE DESLIGAMENTO

A DISTÂNCIA NAS PORTARIAS

Setor de Administração Federal Sul, Quadra 04, Lote 1 -

SAFS, Brasília-DF . 70042-900

Setor de Administração Federal Sul, Quadra 04, Lote 1 - SAFS, Brasília-DF . CEP: 70042-900 Longitude: 15°48'13.9"S, Latitude: 47°51'47.8"O LOCALIZAÇÃO GPS CARACTERÍSTICAS DO SISTEMA

Potência Instalada Total (kWp)*: 286.11 kWp Módulo Fotovoltaico: 867 unidades JA SOLAR / JAP72S01 - 330Wp Inversor: INGETEAM INGECON SUN 3PLAY 100TL Área Ocupada: ~3.746,89 m²

TCU -Tribunal ed Contas da União,

Previsão anual de Geração: ~453.191 kWh/ano

LAYOUT E LOCALIZAÇÃO DO SISTEMA FOTOVOLTAICO
