LuizBraz13/TCU-Projects/Check list PE Anexo I,II e Pergolado/2018-06-05 PROJETOS_V02/PDF/ALOCAÇÃO DOS MÓDULOS/ALOCAÇÃO DE MÓDULOS_ ANEXO II - 01.pdf

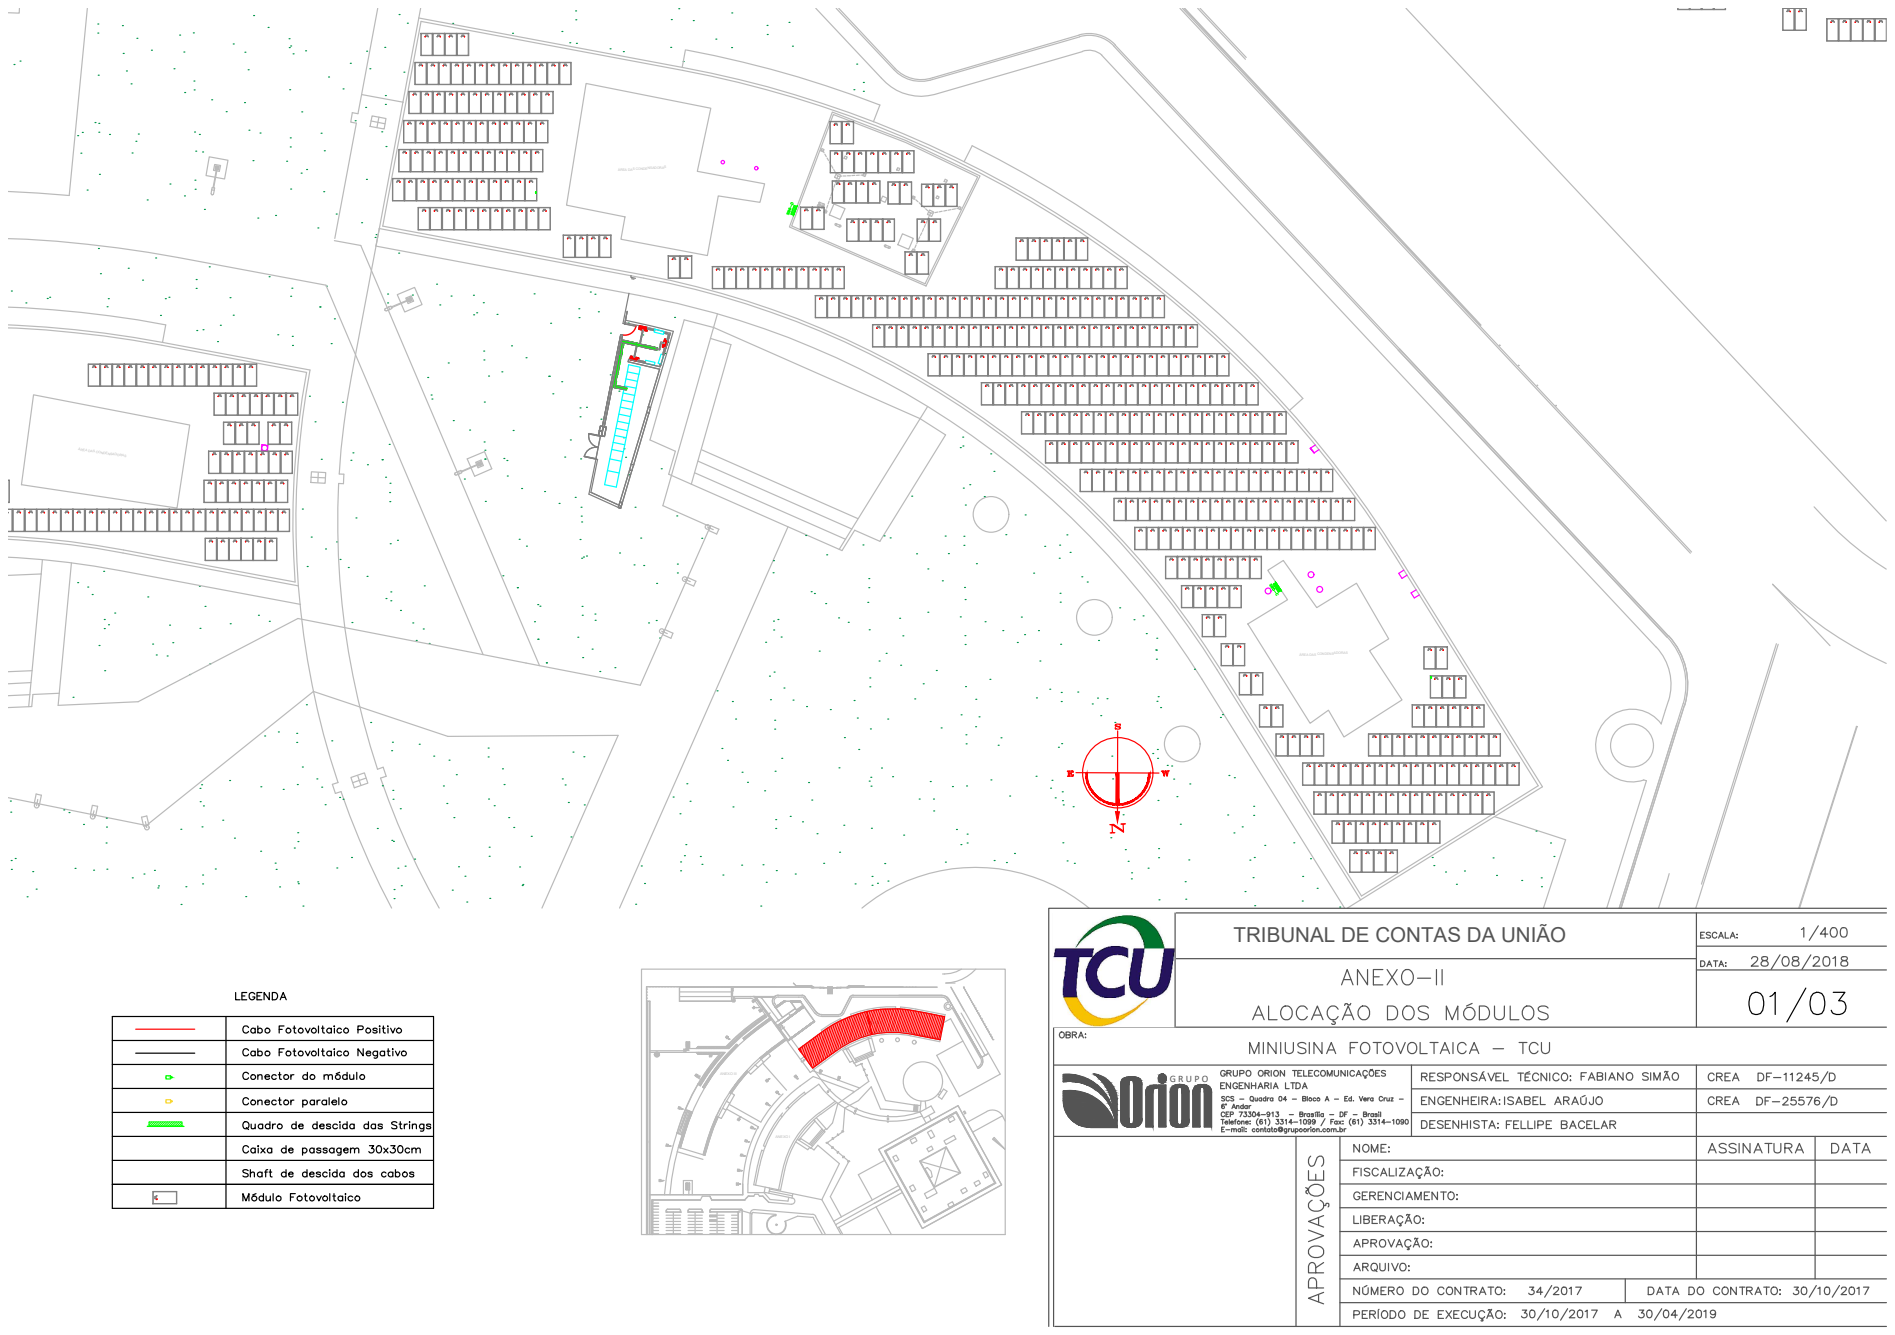
[picture p46: page 1]
ANEXO I; ANEXO II; ANEXO III

ÁREA DAS CONDENSADORAS

TRIBUNAL DE CONTAS DA UNIÃO
