LuizBraz13/TCU-Projects/Check list PE Anexo I,II e Pergolado/2018-06-05 PROJETOS_V02/PDF/ALOCAÇÃO DOS MÓDULOS/ALOCAÇÃO DE MÓDULOS_ ANEXO II - 03.pdf

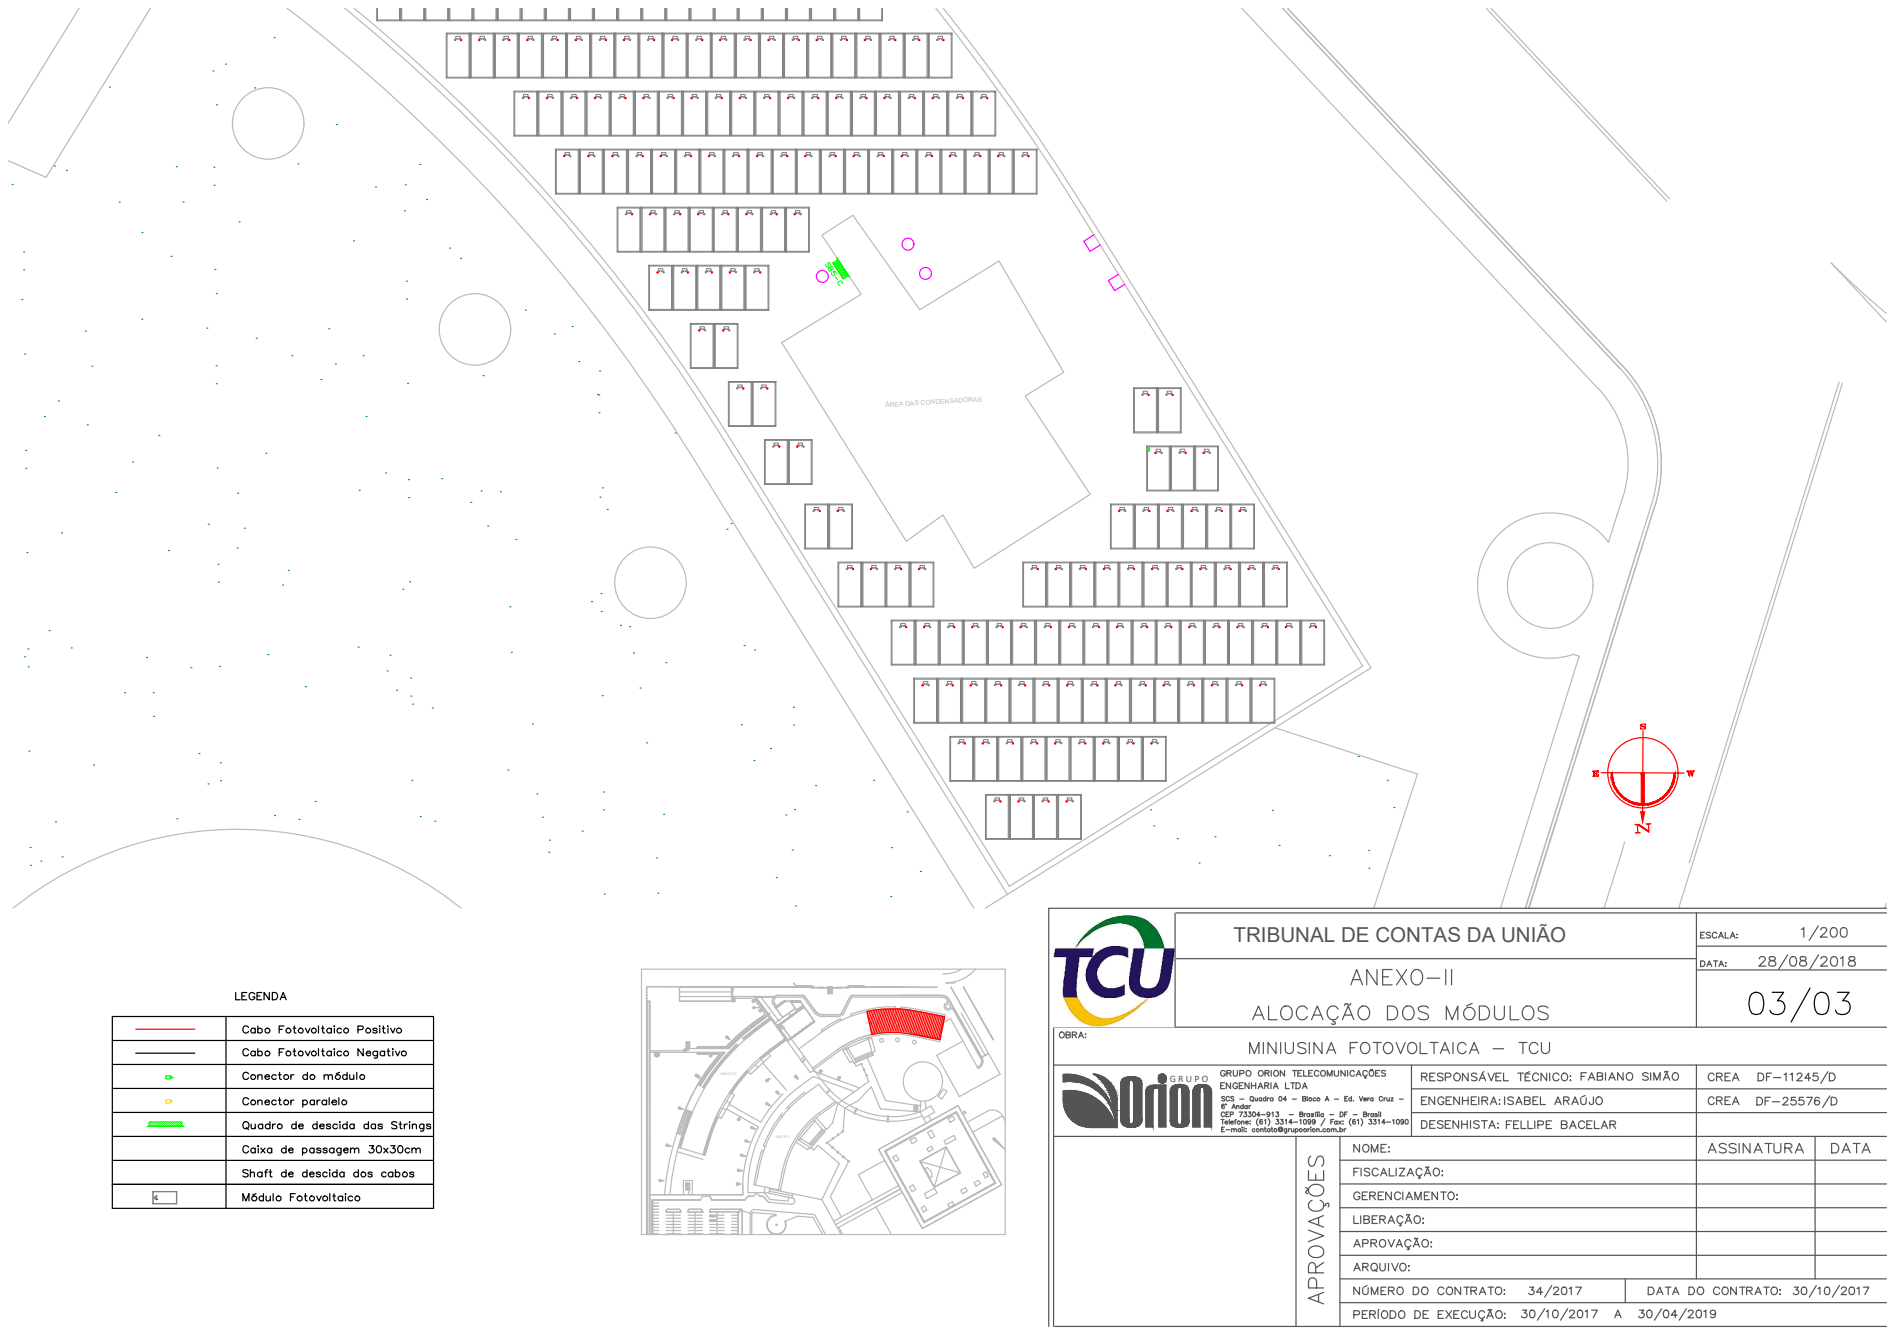
[picture p48: page 1]
ANEXO I; ANEXO II; ANEXO III

ÁREA DAS CONDENSADORAS

TRIBUNAL DE CONTAS DA UNIÃO
