LuizBraz13/TCU-Projects/Check list PE Anexo I,II e Pergolado/2018-06-05 PROJETOS_V02/PDF/ALOCAÇÃO DOS MÓDULOS/ALOCAÇÃO DE MÓDULOS_ PERGOLADO.pdf

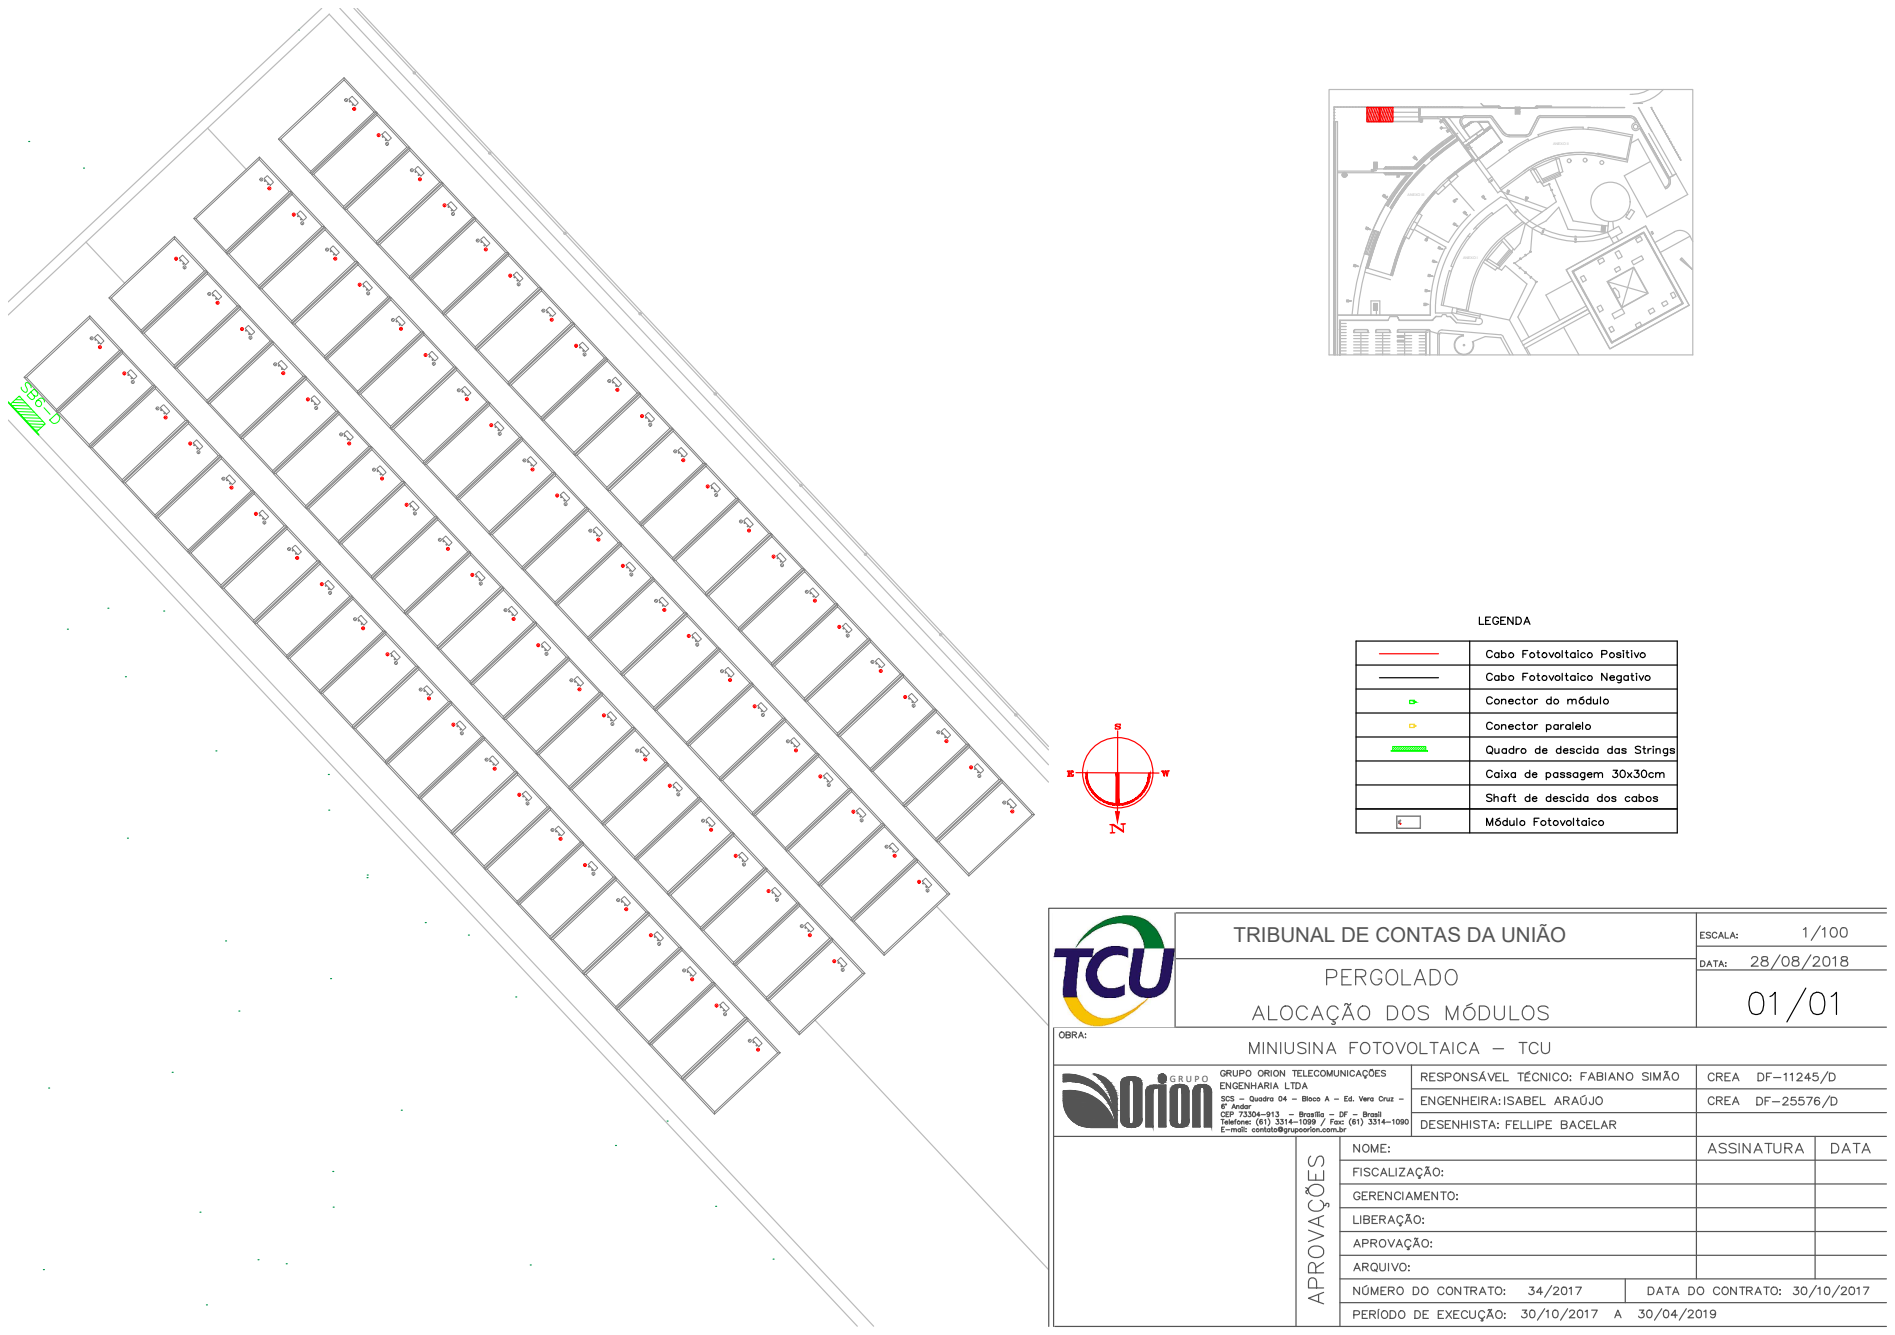
[picture p49: page 1]
ANEXO I; ANEXO II; ANEXO III

TRIBUNAL DE CONTAS DA UNIÃO
