LuizBraz13/TCU-Projects/Check list PE Anexo I,II e Pergolado/2018-06-05 PROJETOS_V02/PDF/INTERCONEXÃO DOS MÓDULOS/INTERCONEXÃO DOS MÓDULOS_ANEXO I - 02_v.08.pdf

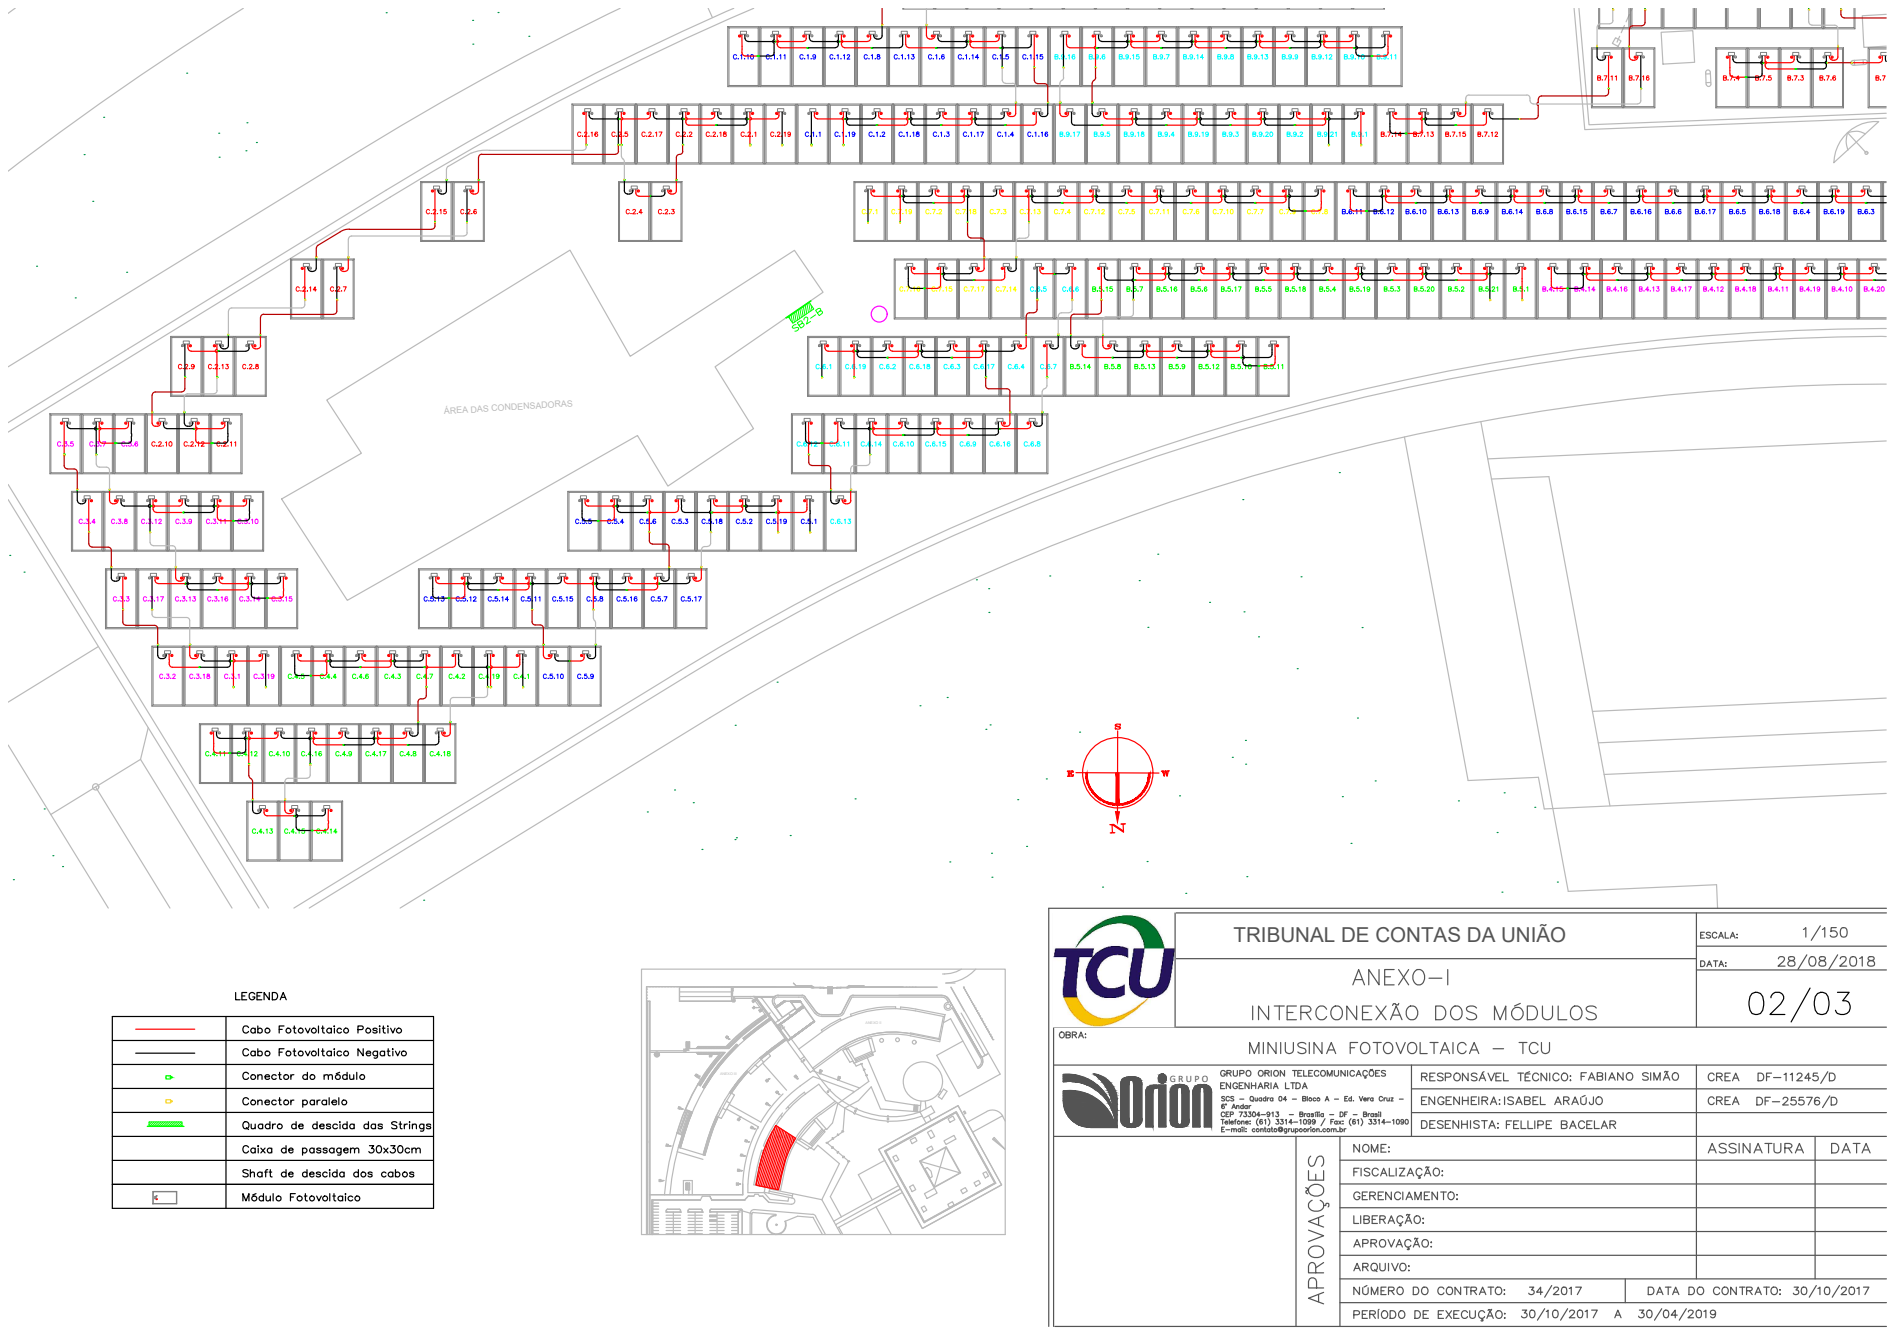
[picture p56: page 1]
ANEXO I; ANEXO II; ANEXO III

ÁREA DAS CONDENSADORAS

TRIBUNAL DE CONTAS DA UNIÃO
