LuizBraz13/TCU-Projects/Check list PE Anexo I,II e Pergolado/2018-06-05 PROJETOS_V02/PDF/INTERCONEXÃO DOS MÓDULOS/INTERCONEXÃO DOS MÓDULOS_PERGOLADO.pdf

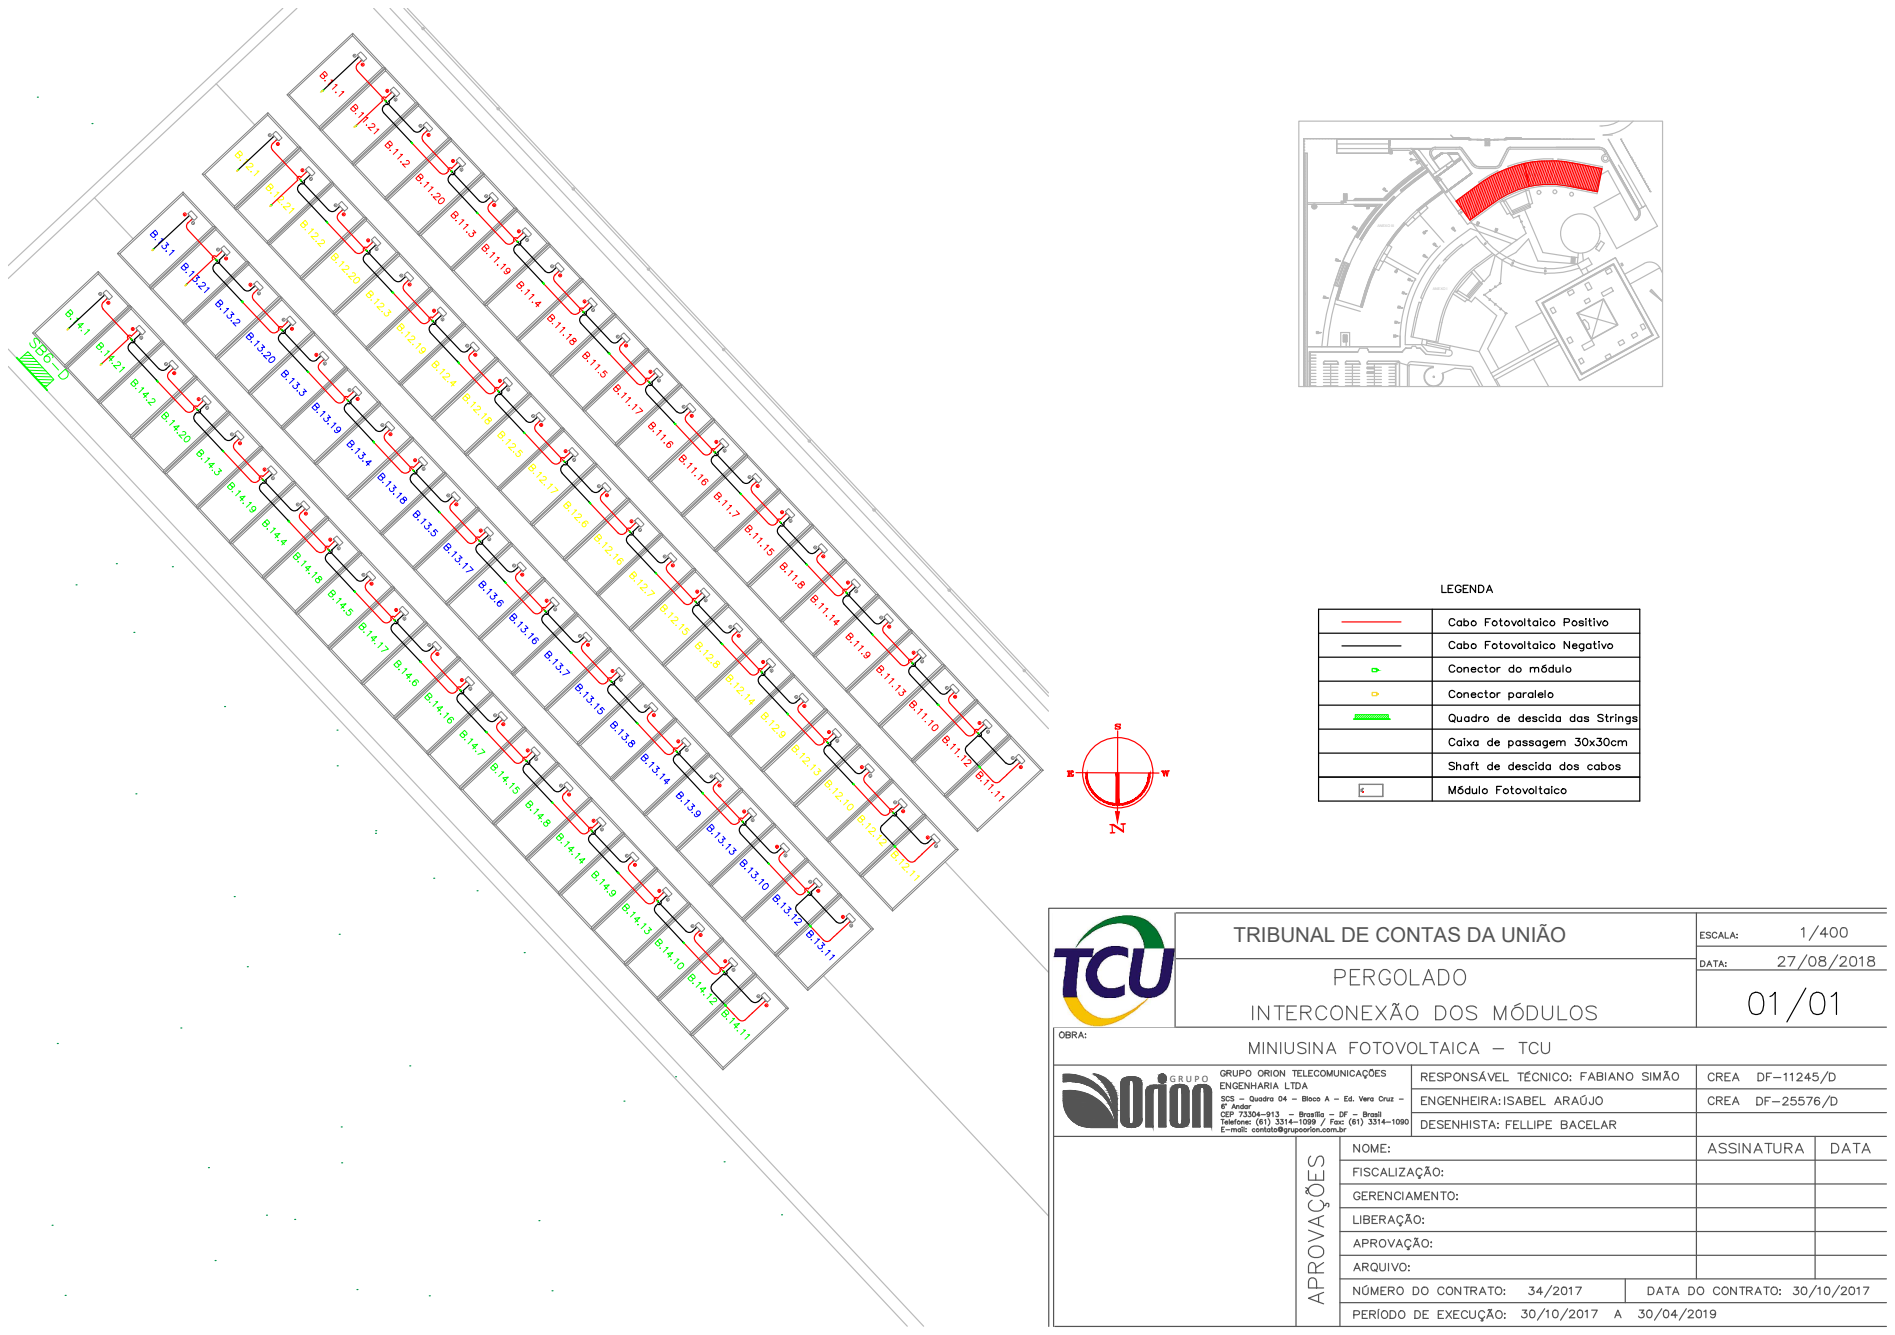
[picture p60: page 1]
ANEXO I; ANEXO II; ANEXO III

TRIBUNAL DE CONTAS DA UNIÃO
