LuizBraz13/TCU-Projects/Check list PE Anexo I,II e Pergolado/2018-06-05 PROJETOS_V02/PDF/UNIFILAR/UNIFILAR_TRIFILAR_ANEXO I, II e PERG_v13.pdf

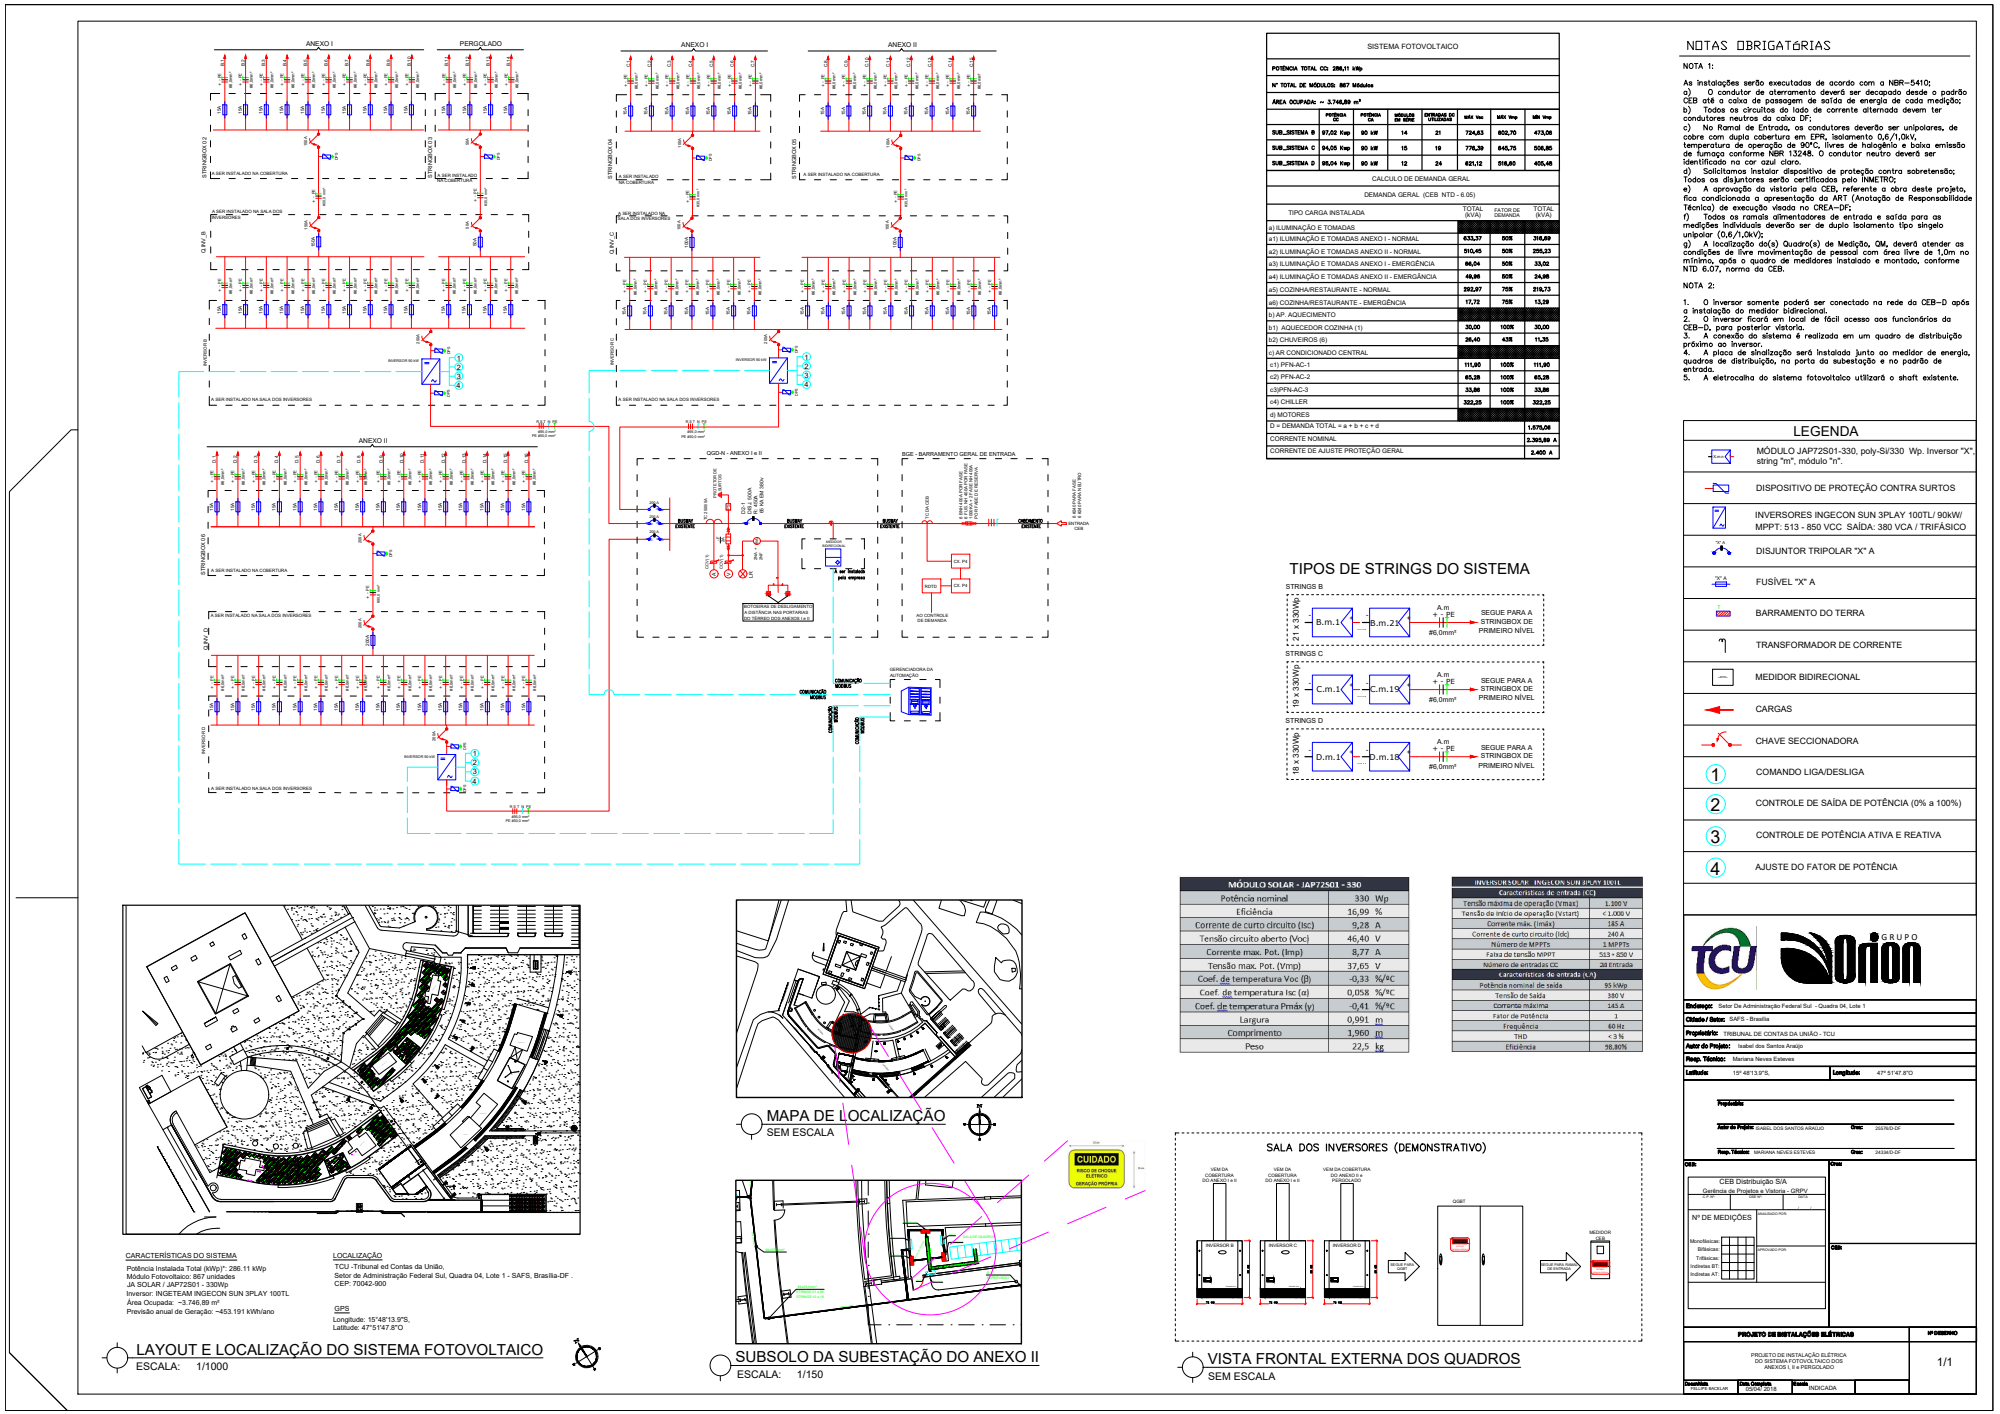
[picture p61: page 1]
#50,0 mm²; #35,0 mm²; ANEXO I; PERGOLADO; RDTD; AO CONTROLE DE DEMANDA TC DA CEB; 6 BNH 400A POR FASE 6 FUS. NH 400A POR FASE 1000KA + 2 FASE NH 400A POR FASE DE RESERVA; 6 #240 PARA FASE 6 #240 PARA NEUTRO; ENTRADA CEB + - PE; #95,0 mm² PE #50,0 mm²; #95,0 mm² PE #50,0 mm² QGD-N - ANEXO I e II; BGE - BARRAMENTO GERAL DE ENTRADA; INVERSORES; #6,0mm² B.11 + - PE; #6,0mm² D.1; + - PE #6,0mm²; #6,0mm²; #6,0mm² STRINGBOX 06; INVERSOR 90 kW; DPS DPS; DPS DPS INVERSOR B; INVERSOR C STRINGBOX 04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

#6,0mm² STRINGBOX 05 100A DPS C.13 C.14 C.15 + - PE + - PE + - PE #6,0mm² #6,0mm² 200A 200A 100A 100A Q.INV_D A SER INSTALADO NA SALA DOS INVERSORES Q.INV_C + - PE + - PE + - PE + - PE + - PE #6,0mm² #6,0mm² #6,0mm² #6,0mm² #6,0mm² + - PE + - PE + - PE #6,0mm² #6,0mm² #6,0mm² + - PE + - PE + - PE + - PE + - PE + - PE + - PE + - PE #6,0mm² #6,0mm² #6,0mm² #6,0mm² #6,0mm² #6,0mm² #6,0mm² #6,0mm² + - PE + - PE + - PE + - PE + - PE + - PE + - PE + - PE + - PE + - PE + - PE + - PE #6,0mm² #6,0mm² #6,0mm² #6,0mm² #6,0mm² #6,0mm² #6,0mm² #6,0mm² #6,0mm² #6,0mm² #6,0mm² #6,0mm² + - PE + - PE #6,0mm² #6,0mm² + - PE + - PE + - PE #6,0mm² #6,0mm²

B.1 B.2 B.3 B.4 B.5 B.6 B.7 B.8 B.9 B.10 B.13 B.14 + - PE + - PE + - PE + - PE + - PE + - PE + - PE + - PE + - PE + - PE + - PE + - PE #6,0mm² #6,0mm² #6,0mm² #6,0mm² #6,0mm² #6,0mm² #6,0mm² #6,0mm² #6,0mm² #6,0mm² #6,0mm²

#6,0mm² 200A DPS C.1 C.2 C.3 C.4 C.5 C.6 C.7 C.8 C.9 C.10 C.11 C.12 + - PE + - PE + - PE + - PE + - PE + - PE + - PE + - PE + - PE + - PE + - PE + - PE #6,0mm² #6,0mm² #6,0mm² #6,0mm² #6,0mm² #6,0mm² #6,0mm² #6,0mm² #6,0mm² #6,0mm² #6,0mm²

#6,0mm² STRINGBOX 02 STRINGBOX 03 150A DPS 50A DPS Q.INV_B 50A 50A 150A 150A + - PE + - PE + - PE + - PE + - PE + - PE + - PE + - PE + - PE + - PE + - PE + - PE + - PE + - PE #6,0mm² #6,0mm² #6,0mm² #6,0mm² #6,0mm² #6,0mm² #6,0mm² #6,0mm² #6,0mm² #6,0mm² #6,0mm² #6,0mm² #6,0mm² #6,0mm² DPS DPS INVERSOR D

A SER INSTALADO NA COBERTURA

CALCULO DE DEMANDA GERAL

A SER INSTALADO NA SALA DOS

A SER INSTALADO NA
SALA DOS INVERSORES

a1) ILUMINAÇÃO E TOMADAS ANEXO I - NORMAL

a2) ILUMINAÇÃO E TOMADAS ANEXO II - NORMAL

a3) ILUMINAÇÃO E TOMADAS ANEXO I - EMERGÊNCIA a4) ILUMINAÇÃO E TOMADAS ANEXO II - EMERGÂNCIA a5) COZINHA/RESTAURANTE - NORMAL

a6) COZINHA/RESTAURANTE - EMERGÊNCIA

b) AP. AQUECIMENTO b1) AQUECEDOR COZINHA (1) b2) CHUVEIROS (6)

c) AR CONDICIONADO CENTRAL

MÓDULO JAP72S01-330, poly-Si/330 Wp. Inversor "X",
string "m", módulo "n".

VLR -F 2A BA 2NA + 2NF CCV (1) CCV (1) TC 2500/5A PS PROTETOR DE SURTOS D2-1 DISJ. 500A R: 450A 65 KA EM 380v

DISPOSITIVO DE PROTEÇÃO CONTRA SURTOS

INVERSORES INGECON SUN 3PLAY 100TL/ 90kW/ DISJUNTOR TRIPOLAR "X" A
MPPT: 513 - 850 VCC SAÍDA: 380 VCA / TRIFÁSICO

TIPOS DE STRINGS DO SISTEMA

BOTOEIRAS DE DESLIGAMENTO
A DISTÂNCIA NAS PORTARIAS DO TÉRREO DOS ANEXOS I e II

TRANSFORMADOR DE CORRENTE

CHAVE SECCIONADORA COMANDO LIGA/DESLIGA CONTROLE DE SAÍDA DE POTÊNCIA (0% a 100%)

#95,0 mm² PE #50,0 mm²

CONTROLE DE POTÊNCIA ATIVA E REATIVA

AJUSTE DO FATOR DE POTÊNCIA

ÁREA DAS CONDENSADORAS

Setor De Administração Federal Sul - Quadra 04, Lote 1

ANEXO I ANEXO II

TRIBUNAL DE CONTAS DA UNIÃO - TCU

Isabel dos Santos Araújo

CASA DE MÁQUINAS

Mariana Neves Esteves

MAPA DE LOCALIZAÇÃO

VEM DA COBERTURA DO ANEXO I e II

VEM DA COBERTURA DO ANEXO II e PERGOLADO

CEB Distribuição S/A
Gerência de Projetos e Vistoria - GRPV

Nº DE MEDIÇÕES

SALA DE QUADROS

Monofásicas: Bifásicas: Trifásicas:

CARACTERÍSTICAS DO SISTEMA

LOCALIZAÇÃO
TCU -Tribunal ed Contas da União, Setor de Administração Federal Sul, Quadra 04, Lote 1 - SAFS, Brasília-DF . CEP: 70042-900

RISCO DE CHOQUE
ELÉTRICO
GERAÇÃO PRÓPRIA

Potência Instalada Total (kWp)*: 286.11 kWp Módulo Fotovoltaico: 867 unidades

SEGUE PARA RAMAL DE ENTRADA

JA SOLAR / JAP72S01 - 330Wp
Inversor: INGETEAM INGECON SUN 3PLAY 100TL Área Ocupada: ~3.746,89 m² Previsão anual de Geração: ~453.191 kWh/ano

LAYOUT E LOCALIZAÇÃO DO SISTEMA FOTOVOLTAICO

SUBSOLO DA SUBESTAÇÃO DO ANEXO II

VISTA FRONTAL EXTERNA DOS QUADROS
SEM ESCALA

PROJETO DE INSTALAÇÃO ELÉTRICA DO SISTEMA FOTOVOLTAICO DOS

ANEXOS I, II e PERGOLADO
